yumenegi/object67/README.md

# object67
Object 67 is an attempt at an AES-67-2013 compliant network D/AC studios and home audio.
