yumenegi/object67/eddy/notes.txt

Eddy's to do list because he's stupid:
    Spec PHY
        Configure in STM32MX

    Configure MCU in MX
        Active peripherals:
            USB PHY
            SPDIFRX
            SAI x2
                Input & output

Notes for display:
    Baud rate 38,400bps
        Configure with J1 and J2
    Find voltage
    Leave J2 open for Asynchronous
