yumenegi/object67/kicad_libs/LIB_TORX1950A_F_/TORX1950A_F_/3D/TORX1950A_F_.stp

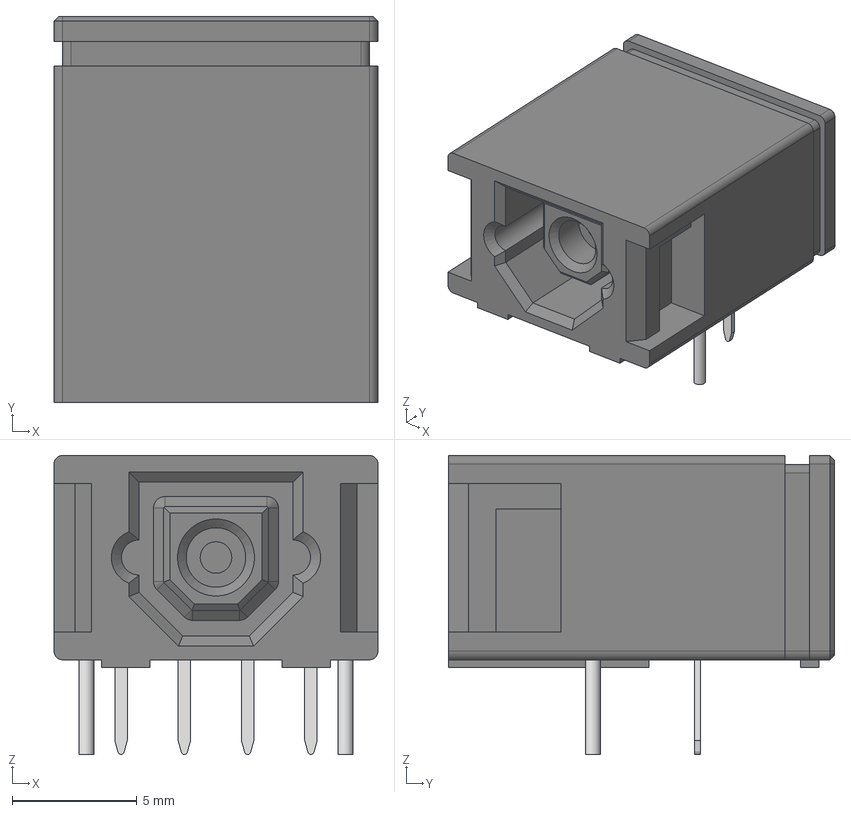
[picture p1: CAD file, 2026-02-16]
kicad_libs/LIB_TORX1950A_F_/TORX1950A_F_/3D/TORX1950A_F_.stp
13.0 x 15.5 x 12.0 mm
