yumenegi/object67/models/ADP5070AREZ/3D/ADP5070AREZ.stp

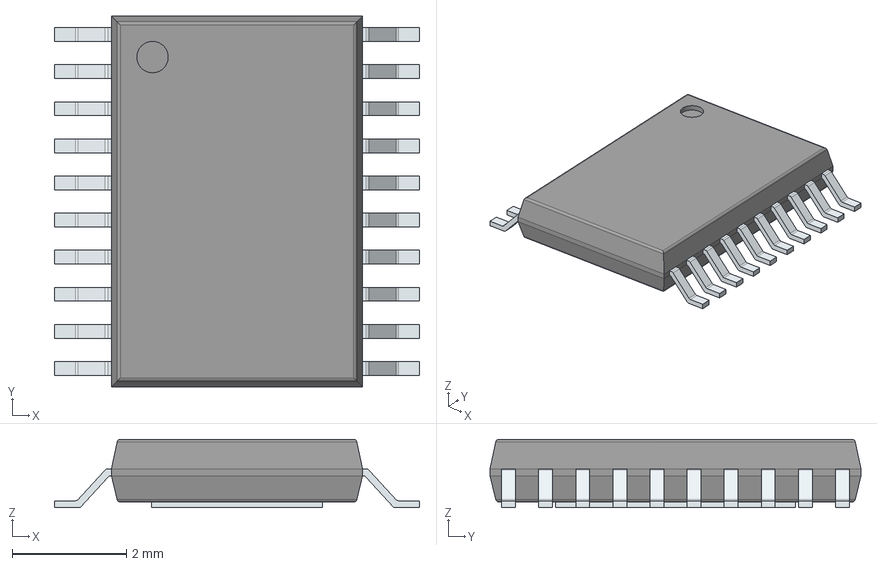
[picture p2: CAD file, 2026-03-09]
models/ADP5070AREZ/3D/ADP5070AREZ.stp
6.40 x 6.50 x 1.20 mm
PinsArrayLR
ThermalPad
