yumenegi/object67/models/AK4493SEQ/3D/AK4493SEQ.stp

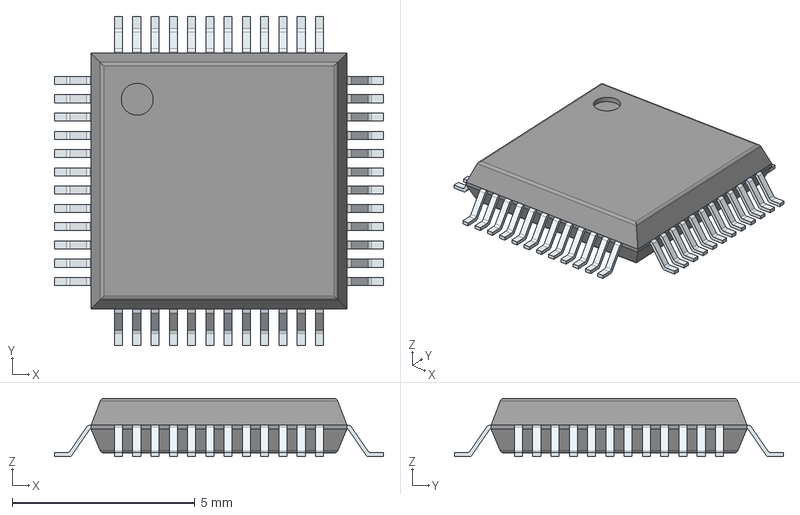
[picture p3: CAD file, 2026-02-12]
models/AK4493SEQ/3D/AK4493SEQ.stp
9.00 x 9.00 x 1.60 mm
PinsArrayLR
PinsArrayTB
