yumenegi/object67/models/AK5572EN/3D/AK5572EN.stp

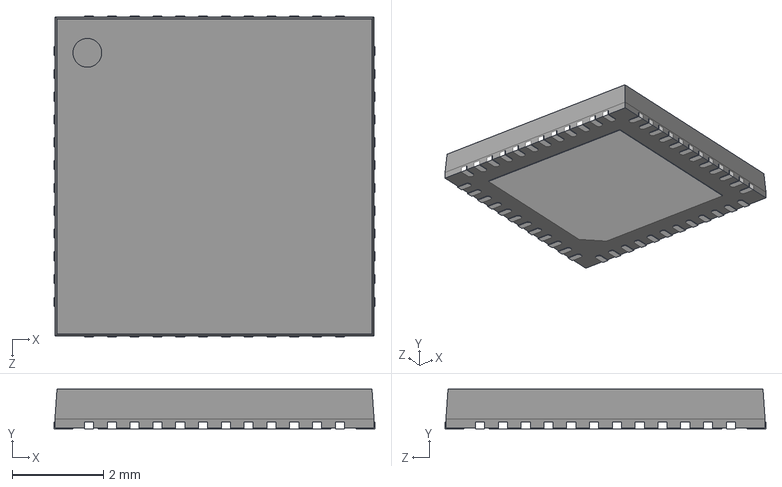
[picture p4: CAD file, 2026-02-12]
models/AK5572EN/3D/AK5572EN.stp
7.04 x 0.87 x 7.04 mm
