yumenegi/object67/models/ASDLJ-E-45.1584MHz-L-R-T/3D/ASDLJ-E-45.1584MHz-L-R-T.stp

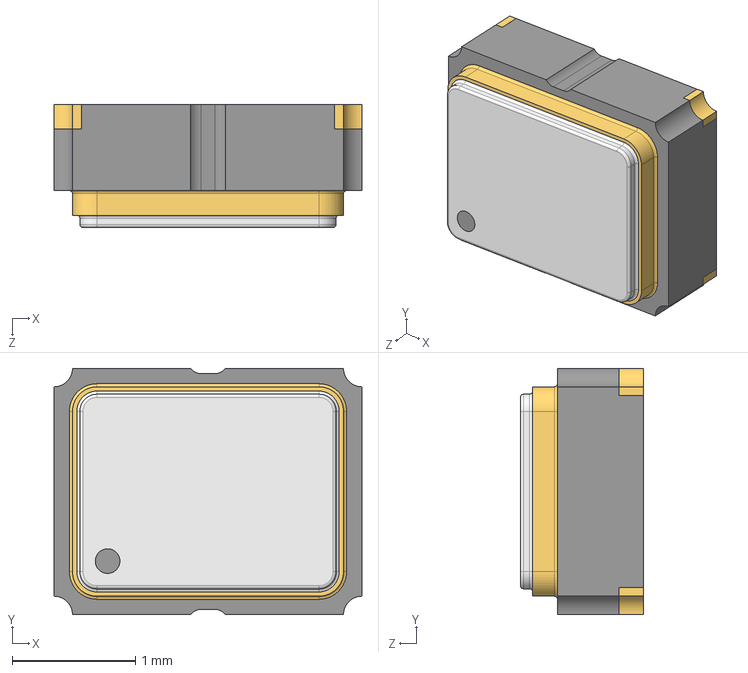
[picture p5: CAD file, 2026-03-07]
models/ASDLJ-E-45.1584MHz-L-R-T/3D/ASDLJ-E-45.1584MHz-L-R-T.stp
2.50 x 2.00 x 1.00 mm
