yumenegi/object67/models/ASDLJ-E-49.152MHZ-L-R-T/3D/ASDLJ-E-49.152MHZ-L-R-T.stp

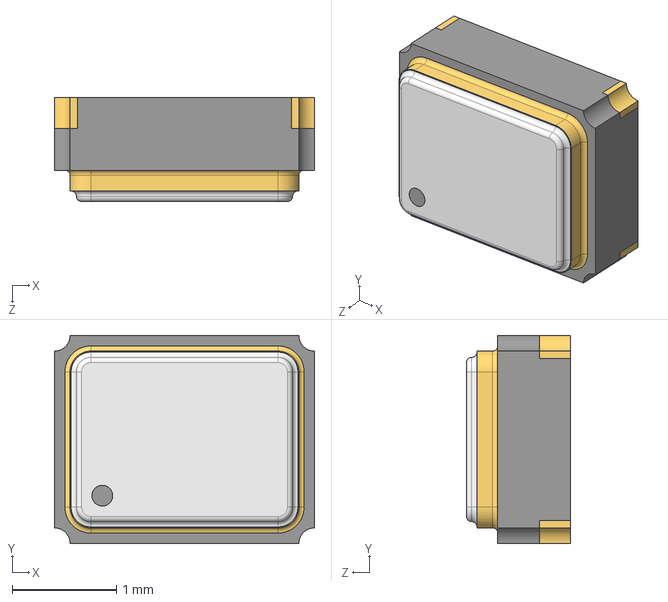
[picture p6: CAD file, 2026-03-07]
models/ASDLJ-E-49.152MHZ-L-R-T/3D/ASDLJ-E-49.152MHZ-L-R-T.stp
2.50 x 2.00 x 1.00 mm
