yumenegi/object67/models/DQN0004A/DQN0004A.stp

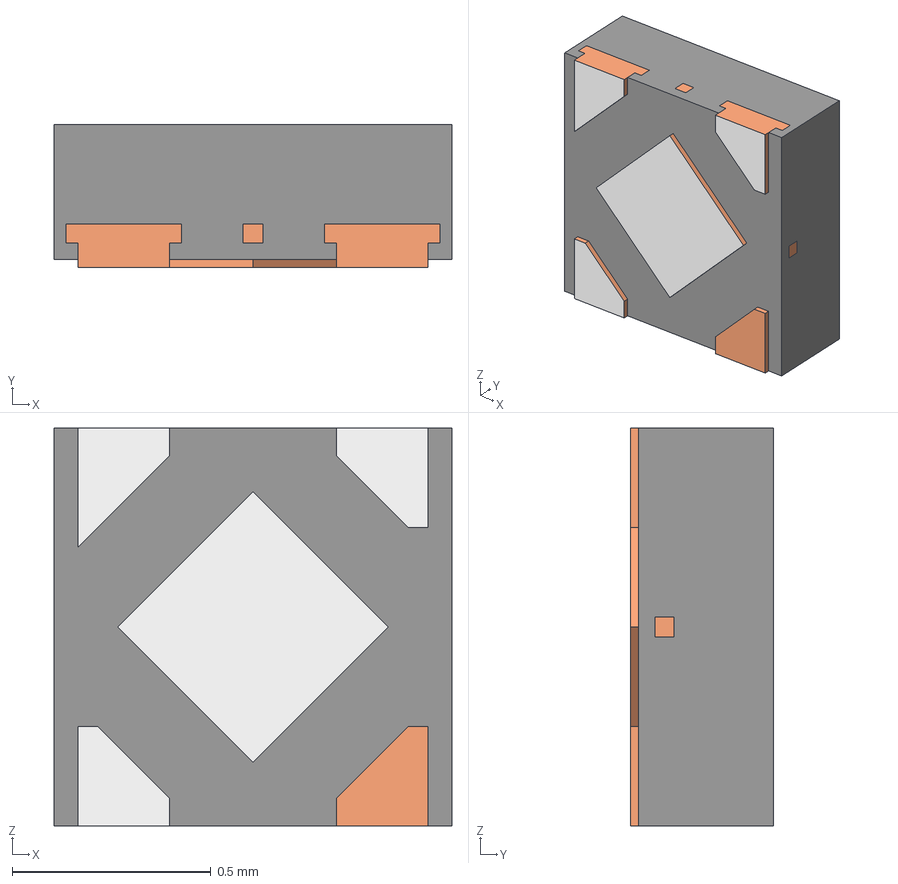
[picture p7: CAD file, 2026-03-09]
models/DQN0004A/DQN0004A.stp
1.00 x 0.36 x 1.00 mm
MOLD-SNB04A
FRAME-SNB04A
