yumenegi/object67/models/LMK1C1104DQFR/3D/LMK1C1104DQFR.stp

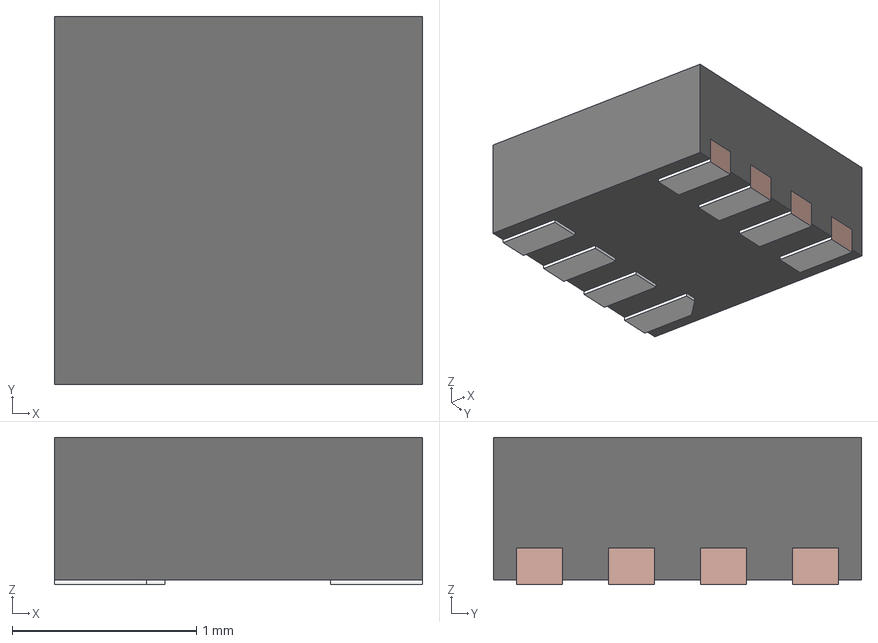
[picture p8: CAD file, 2026-02-12]
models/LMK1C1104DQFR/3D/LMK1C1104DQFR.stp
2.00 x 2.00 x 0.8 mm
FRAME
MOLD
