yumenegi/object67/models/LMK1C1104PWR/3D/LMK1C1104PWR.stp

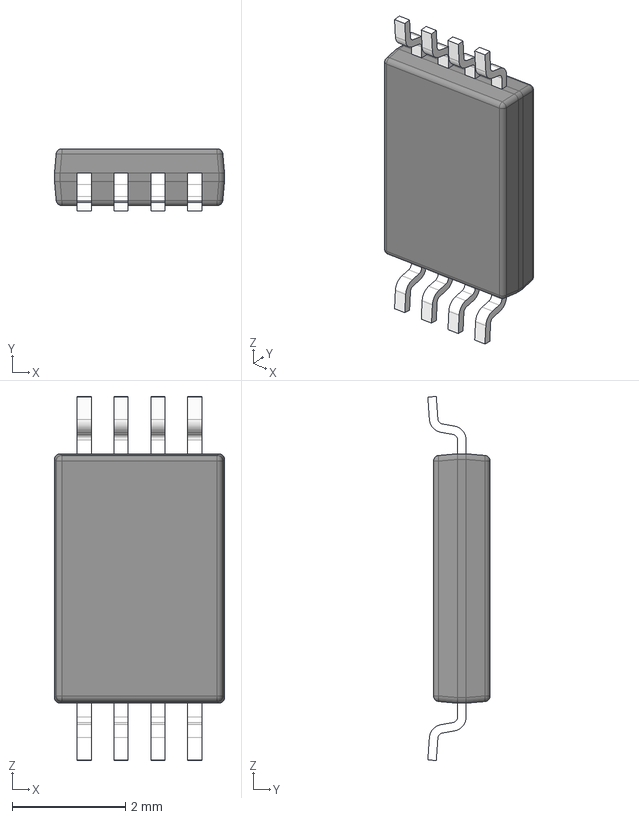
[picture p9: CAD file, 2026-02-12]
models/LMK1C1104PWR/3D/LMK1C1104PWR.stp
3.00 x 1.10 x 6.42 mm
BODY-SO
LEAD-SO x 8
PIN1-ID
