yumenegi/object67/models/OPA1612AIDRGR/3D/OPA1612AIDRGR.stp

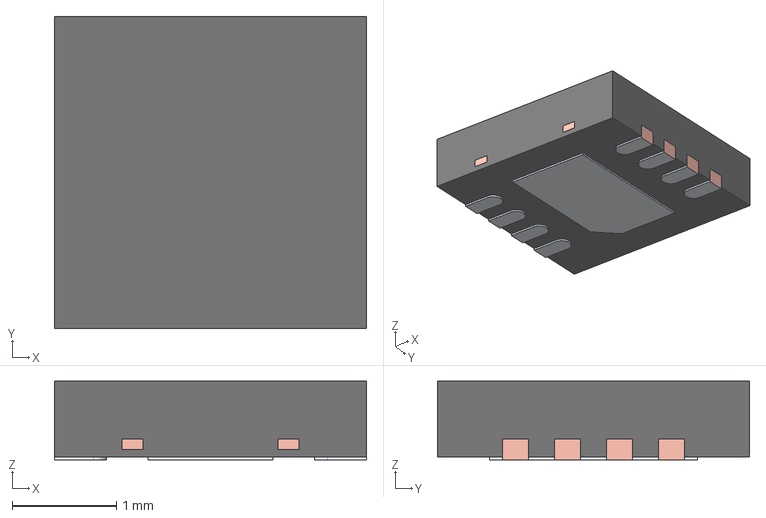
[picture p10: CAD file, 2026-03-09]
models/OPA1612AIDRGR/3D/OPA1612AIDRGR.stp
3.00 x 3.00 x 0.755 mm
BODY-SON
FRAME-DRG0008A
