yumenegi/object67/models/PJ-037A/3D/PJ-037A.stp

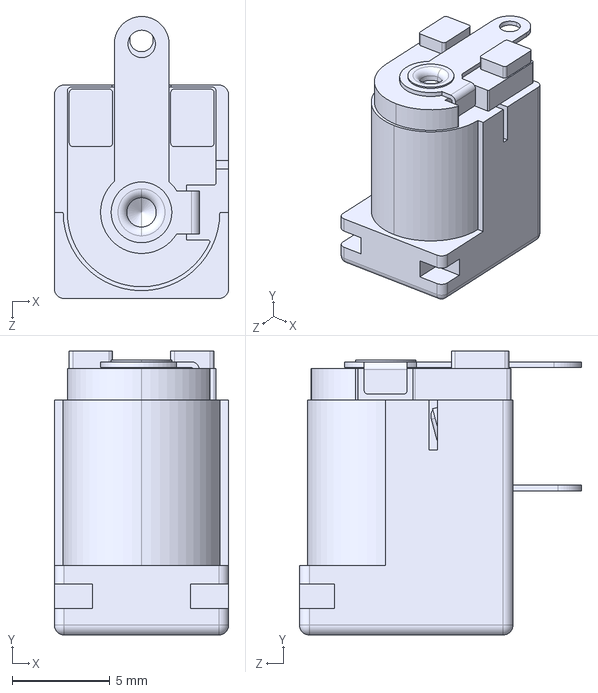
[picture p11: CAD file, 2026-03-07]
models/PJ-037A/3D/PJ-037A.stp
8.90 x 14.5 x 14.4 mm
