yumenegi/object67/models/RCJ2223/RCJ-2223.step

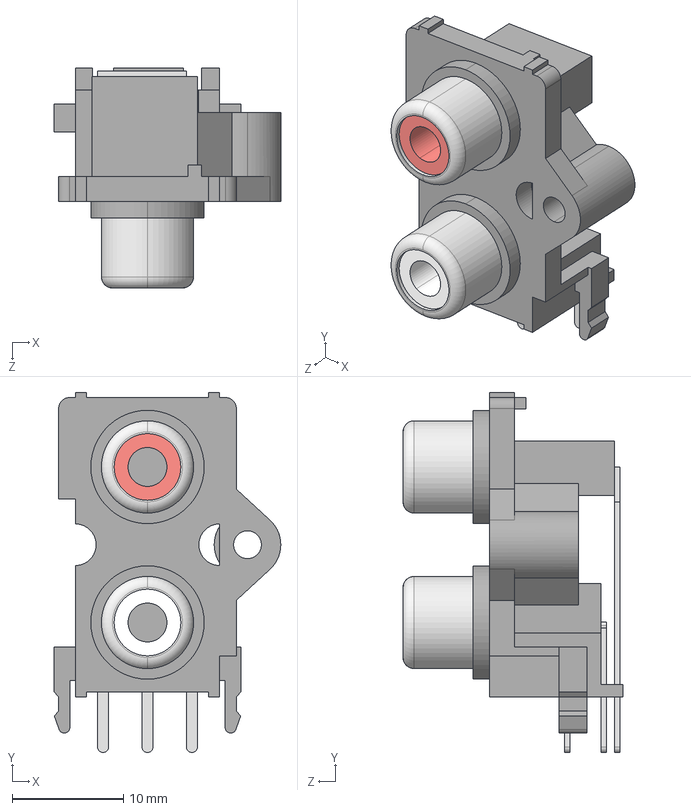
[picture p12: CAD file, 2026-02-24]
models/RCJ2223/RCJ-2223.step
20.4 x 32.4 x 19.8 mm
RCJ-22_RCJ-22XX
PLUG_Red
PLUG_White
