yumenegi/object67/models/TAA5242IRGER/3D/TAA5242IRGER.stp

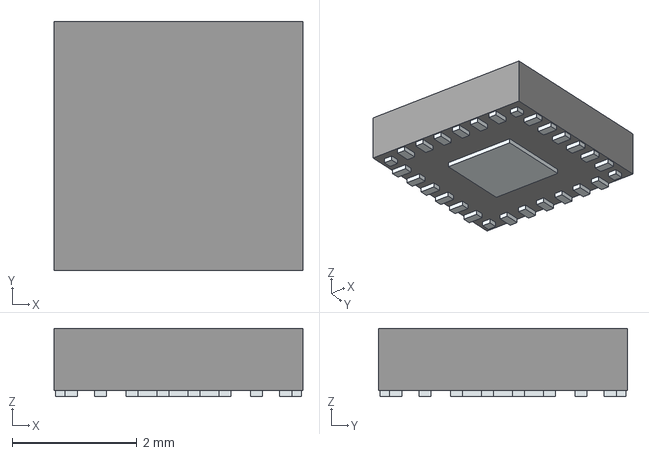
[picture p13: CAD file, 2026-02-12]
models/TAA5242IRGER/3D/TAA5242IRGER.stp
4.00 x 4.00 x 1.10 mm
Pins
