yumenegi/object67/models/TPA6120A2DWPR/3D/TPA6120A2DWPR.stp

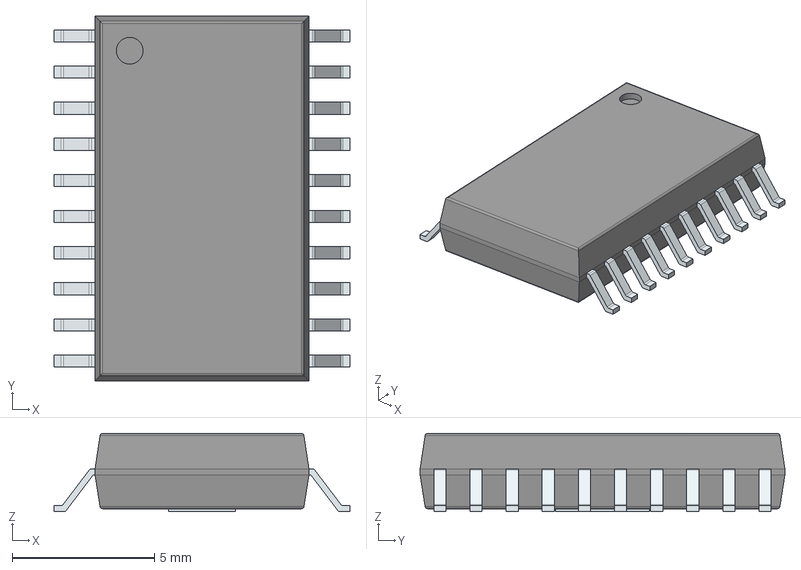
[picture p14: CAD file, 2026-02-24]
models/TPA6120A2DWPR/3D/TPA6120A2DWPR.stp
10.4 x 12.8 x 2.75 mm
PinsArrayLR
ThermalPad
