yumenegi/object67/models/TPS62912/RPU0010A.stp

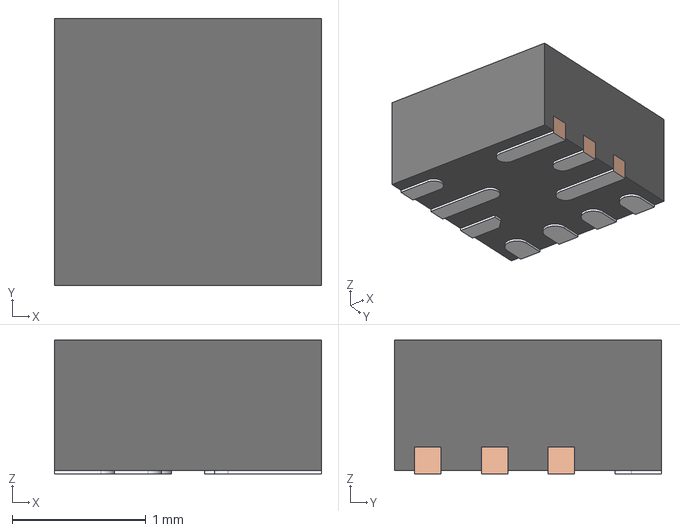
[picture p15: CAD file, 2026-03-09]
models/TPS62912/RPU0010A.stp
2.00 x 2.00 x 1.00 mm
FRAME
MOLD
