yumenegi/object67/models/TPS7A3301RGWR/3D/TPS7A3301RGWR.stp

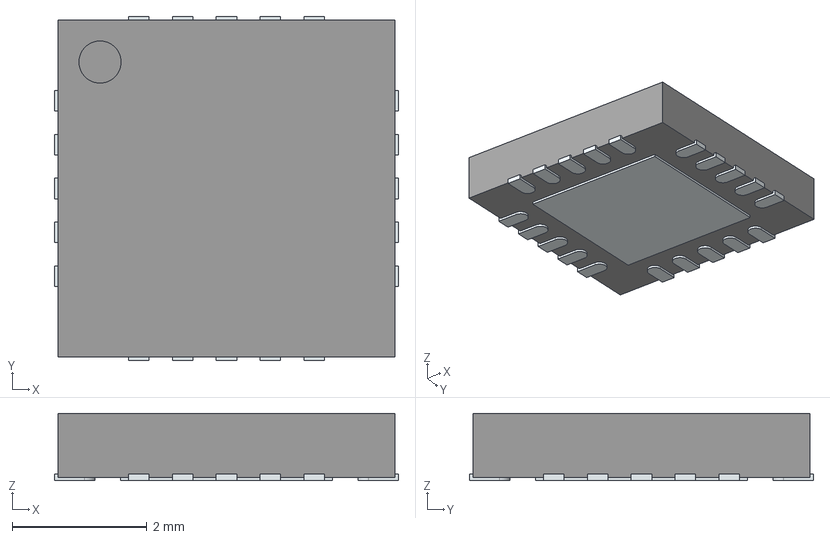
[picture p16: CAD file, 2026-03-07]
models/TPS7A3301RGWR/3D/TPS7A3301RGWR.stp
5.10 x 5.10 x 1.00 mm
ThermalPin
PinsArrayLR
PinsArrayTB
