yumenegi/object67/models/216700-0249/3D/216700-0249.stp

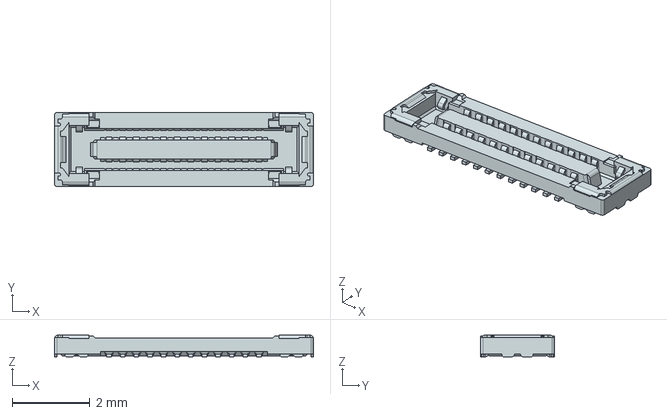
[picture p17: CAD file, 2026-03-07]
models/216700-0249/3D/216700-0249.stp
6.65 x 1.90 x 0.56 mm
