yumenegi/object67/(list of files, cad)

Other CAD files:
models/TPS7A4701RGWT/3D/TPS7A4701RGWT.stp
kicad_libs/LIB_TORX1950A_F_/TORX1950A_F_/Allegro/torx1950af.psm
kicad_libs/LIB_TORX1950A_F_/TORX1950A_F_/DEHDL/torx1950a_f_/chips/chips.prt
models/216700-0249/Allegro/2167000249.psm
models/216700-0249/DEHDL/216700_0249/chips/chips.prt
models/505270-2412/3D/505270-2412.stp
models/505270-2412/Allegro/5052702412.psm
models/505270-2412/DEHDL/505270_2412/chips/chips.prt
models/ADP5070AREZ/Allegro/sop65p640x120-21n.psm
models/ADP5070AREZ/DEHDL/adp5070arez/chips/chips.prt
models/AK4493SEQ/Allegro/qfp50p900x900x160-48n.psm
models/AK4493SEQ/DEHDL/ak4493seq/chips/chips.prt
models/AK5572EN/Allegro/qfn50p700x700x100-49n-d.psm
models/AK5572EN/DEHDL/ak5572en/chips/chips.prt
models/ASDLJ-E-45.1584MHz-L-R-T/Allegro/asdlje451584mhzlrt.psm
models/ASDLJ-E-45.1584MHz-L-R-T/DEHDL/asdlj_e_45.1584mhz_l_r_t/chips/chips.prt
models/ASDLJ-E-49.152MHZ-L-R-T/Allegro/asdlje49152mhzlrt.psm
models/ASDLJ-E-49.152MHZ-L-R-T/DEHDL/asdlj_e_49.152mhz_l_r_t/chips/chips.prt
models/LMK1C1104DQFR/Allegro/son50p200x200x80-8n.psm
models/LMK1C1104DQFR/DEHDL/lmk1c1104dqfr/chips/chips.prt
models/LMK1C1104PWR/Allegro/sop65p640x120-8n.psm
models/LMK1C1104PWR/DEHDL/lmk1c1104pwr/chips/chips.prt
models/OPA1612AIDRGR/Allegro/son50p300x300x80-9n-d.psm
models/OPA1612AIDRGR/DEHDL/opa1612aidrgr/chips/chips.prt
models/PJ-037A/Allegro/pj037a.psm
models/PJ-037A/DEHDL/pj_037a/chips/chips.prt
models/TAA5242IRGER/Allegro/taa5242irger.psm
models/TAA5242IRGER/DEHDL/taa5242irger/chips/chips.prt
models/TPA6120A2DWPR/Allegro/soic127p1040x275-21n.psm
models/TPA6120A2DWPR/DEHDL/tpa6120a2dwpr/chips/chips.prt
models/TPS7A3301RGWR/Allegro/qfn65p500x500x100-21n-d.psm
models/TPS7A3301RGWR/DEHDL/tps7a3301rgwr/chips/chips.prt
models/TPS7A4701RGWT/Allegro/qfn65p500x500x100-21n-d.psm
models/TPS7A4701RGWT/DEHDL/tps7a4701rgwt/chips/chips.prt
