yumenegi/object67/(list of files, drawings)

Other design files:
models/216700-0249/Altium/216700-0249.SchLib
models/216700-0249/Altium/2167000249.PcbLib
models/505270-2412/Altium/505270-2412.SchLib
models/505270-2412/Altium/5052702412.PcbLib
models/ADP5070AREZ/Altium/ADP5070AREZ.SchLib
models/ADP5070AREZ/Altium/SOP65P640X120-21N.PcbLib
models/AK4493SEQ/Altium/AK4493SEQ.SchLib
models/AK4493SEQ/Altium/QFP50P900X900X160-48N.PcbLib
models/AK5572EN/Altium/AK5572EN.SchLib
models/AK5572EN/Altium/QFN50P700X700X100-49N-D.PcbLib
models/ASDLJ-E-45.1584MHz-L-R-T/Altium/ASDLJ-E-45.1584MHz-L-R-T.SchLib
models/ASDLJ-E-45.1584MHz-L-R-T/Altium/ASDLJE451584MHzLRT.PcbLib
models/ASDLJ-E-49.152MHZ-L-R-T/Altium/ASDLJ-E-49.152MHZ-L-R-T.SchLib
models/ASDLJ-E-49.152MHZ-L-R-T/Altium/ASDLJE49152MHZLRT.PcbLib
models/LMK1C1104DQFR/Altium/LMK1C1104DQFR.SchLib
models/LMK1C1104DQFR/Altium/SON50P200X200X80-8N.PcbLib
models/LMK1C1104PWR/Altium/LMK1C1104PWR.SchLib
models/LMK1C1104PWR/Altium/SOP65P640X120-8N.PcbLib
models/OPA1612AIDRGR/Altium/OPA1612AIDRGR.SchLib
models/OPA1612AIDRGR/Altium/SON50P300X300X80-9N-D.PcbLib
models/PJ-037A/Altium/PJ037A.PcbLib
models/PJ-037A/Altium/PJ-037A.SchLib
models/TAA5242IRGER/Altium/TAA5242IRGER.PcbLib
models/TAA5242IRGER/Altium/TAA5242IRGER.SchLib
models/TPA6120A2DWPR/Altium/SOIC127P1040X275-21N.PcbLib
models/TPA6120A2DWPR/Altium/TPA6120A2DWPR.SchLib
models/TPS7A3301RGWR/Altium/QFN65P500X500X100-21N-D.PcbLib
models/TPS7A3301RGWR/Altium/TPS7A3301RGWR.SchLib
models/TPS7A4701RGWT/Altium/QFN65P500X500X100-21N-D.PcbLib
models/TPS7A4701RGWT/Altium/TPS7A4701RGWT.SchLib
