yumenegi/object67/motor_board/motor_board.kicad_pcb

## KiCad design motor_board/motor_board.kicad_pcb (2026-03-22)

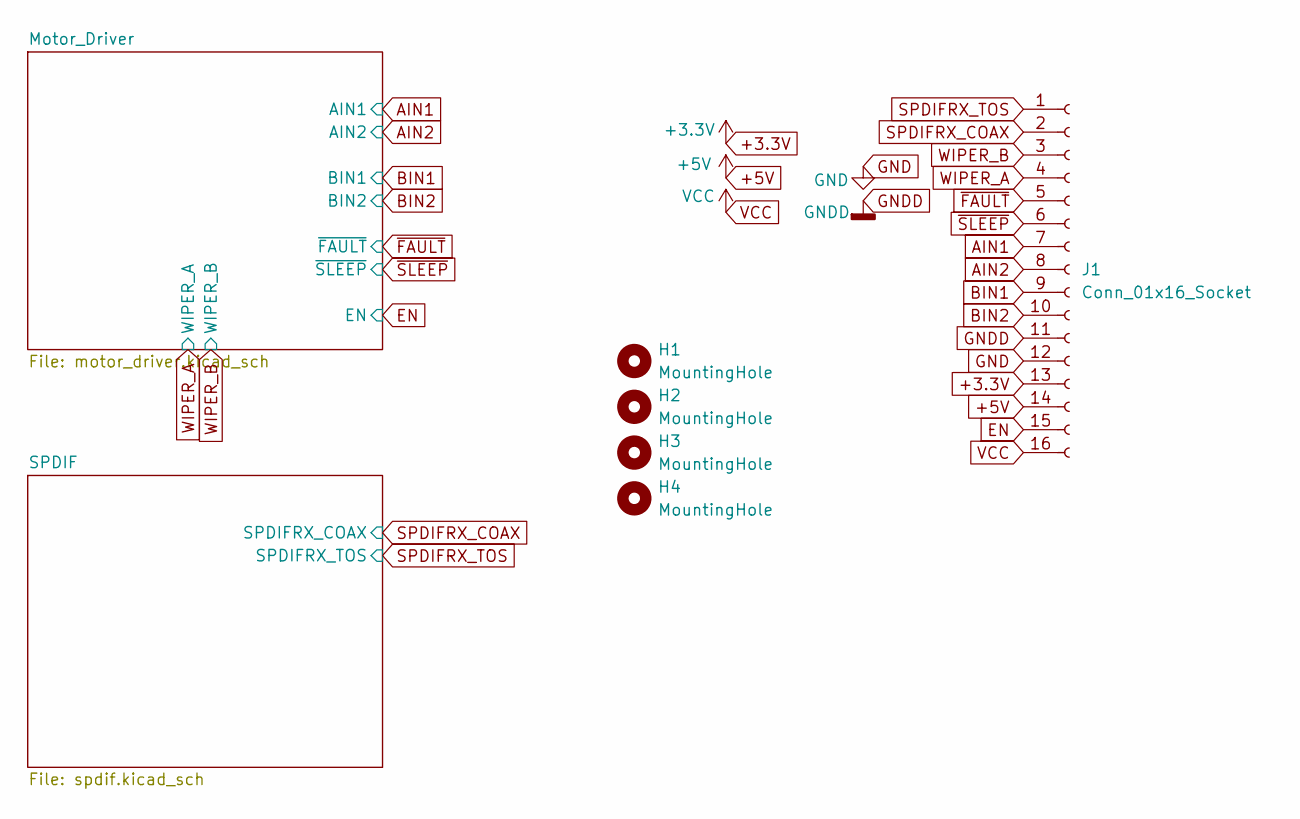
[picture p18: schematic motor_board.kicad_sch]

Parts:
H1, H2, H3, H4: MountingHole; MountingHole_3.2mm_M3
J1: Conn_01x16_Socket; JST_PH_S16B-PH-K_1x16_P2.00mm_Horizontal

Connections:
+3.3V: J1.13; also elsewhere on the board
+5V: J1.14; also elsewhere on the board
AIN1: J1.7; also elsewhere on the board
AIN2: J1.8; also elsewhere on the board
BIN1: J1.9; also elsewhere on the board
BIN2: J1.10; also elsewhere on the board
EN: J1.15; also elsewhere on the board
GND: J1.12; also elsewhere on the board
GNDD: J1.11; also elsewhere on the board
SPDIFRX_COAX: J1.2; also elsewhere on the board
SPDIFRX_TOS: J1.1; also elsewhere on the board
VCC: J1.16; also elsewhere on the board
WIPER_A: J1.4; also elsewhere on the board
WIPER_B: J1.3; also elsewhere on the board
~FAULT: J1.5; also elsewhere on the board
~SLEEP: J1.6; also elsewhere on the board

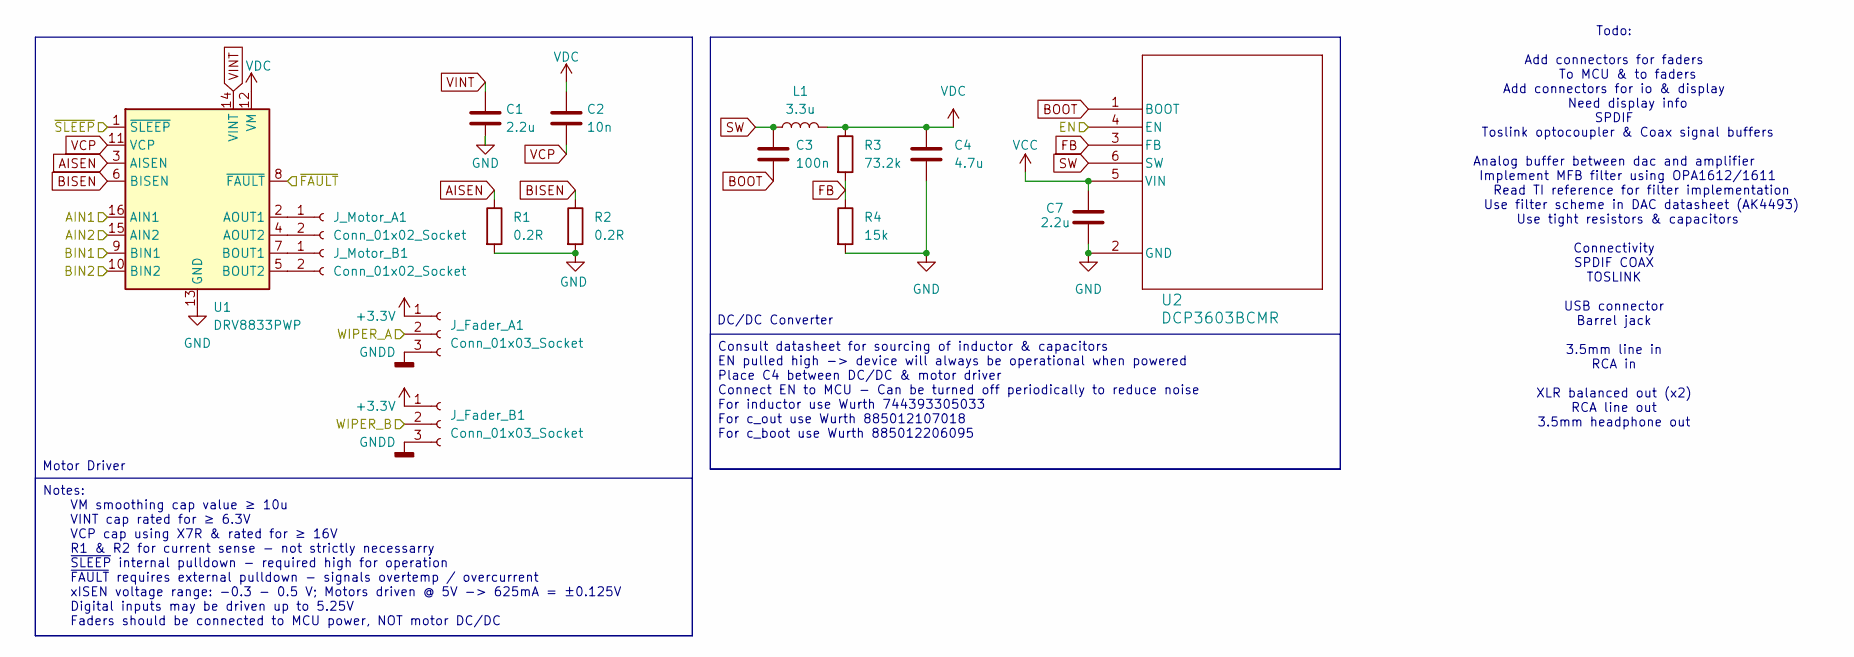
[picture p19: schematic motor_driver.kicad_sch]

Parts:
C1, C7: 2.2u; C_0805_2012Metric_Pad1.18x1.45mm_HandSolder
C2: 10n; C_0805_2012Metric_Pad1.18x1.45mm_HandSolder
C3: 100n; C_0603_1608Metric_Pad1.08x0.95mm_HandSolder
C4: 4.7u; C_0805_2012Metric_Pad1.18x1.45mm_HandSolder
J_Fader_A1: Conn_01x03_Socket; JST_PH_B3B-PH-K_1x03_P2.00mm_Vertical
J_Fader_B1: Conn_01x03_Socket; JST_PH_B3B-PH-K_1x03_P2.00mm_Vertical
J_Motor_A1: Conn_01x02_Socket; JST_PH_B2B-PH-K_1x02_P2.00mm_Vertical
J_Motor_B1: Conn_01x02_Socket; JST_PH_B2B-PH-K_1x02_P2.00mm_Vertical
L1: 3.3u; 744393665033
R1, R2: 0.2R; R_2512_6332Metric_Pad1.40x3.35mm_HandSolder
R3: 73.2k; R_0402_1005Metric_Pad0.72x0.64mm_HandSolder
R4: 15k; R_0402_1005Metric_Pad0.72x0.64mm_HandSolder
U1: DRV8833PWP; HTSSOP-16-1EP_4.4x5mm_P0.65mm_EP3.4x5mm_Mask2.46x2.31mm_The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
U2: DCP3603BCMR; SOT23-6L_1p7x3p01_STM

Connections:
+3.3V: J_Fader_A1.1, J_Fader_B1.1; also elsewhere on the board
AIN1: U1.16 (AIN1); also elsewhere on the board
AIN2: U1.15 (AIN2); also elsewhere on the board
AISEN: R1.1, U1.3 (AISEN)
BIN1: U1.9 (BIN1); also elsewhere on the board
BIN2: U1.10 (BIN2); also elsewhere on the board
BISEN: R2.1, U1.6 (BISEN)
BOOT: C3.2, U2.1 (BOOT)
EN: U2.4 (EN); also elsewhere on the board
FB: R3.2, R4.1, U2.3 (FB)
GND: C1.2, C4.2, C7.2, R1.2, R2.2, R4.2, U1.13 (GND), U1.17 (GND), U2.2 (GND); also elsewhere on the board
GNDD: J_Fader_A1.3, J_Fader_B1.3; also elsewhere on the board
unnamed: J_Motor_A1.1, U1.2 (AOUT1)
unnamed: J_Motor_A1.2, U1.4 (AOUT2)
unnamed: J_Motor_B1.1, U1.7 (BOUT1)
unnamed: J_Motor_B1.2, U1.5 (BOUT2)
SW: C3.1, L1.1, U2.6 (SW)
VCC: C7.1, U2.5 (VIN); also elsewhere on the board
VCP: C2.2, U1.11 (VCP)
VDC: C2.1, C4.1, L1.2, R3.1, U1.12 (VM)
VINT: C1.1, U1.14 (VINT)
WIPER_A: J_Fader_A1.2; also elsewhere on the board
WIPER_B: J_Fader_B1.2; also elsewhere on the board
~FAULT: U1.8 (~FAULT); also elsewhere on the board
~SLEEP: U1.1 (~SLEEP); also elsewhere on the board

Notes on the sheet:
DC/DC Converter
Motor Driver
Todo: Add connectors for faders To MCU & to faders Add connectors for io & display Need display info SPDIF Toslink optocoupler & Coax signal buffers Analog buffer between dac and amplifier Implement MFB filter using OPA1612/1611 Read TI reference for filter implementation Use filter scheme in DAC d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
Notes: VM smoothing cap value ≥ 10u VINT cap rated for ≥ 6.3V VCP cap using X7R & rated for ≥ 16V R1 & R2 for current sense - not strictly necessarry ~{SLEEP} internal pulldown - required high for operation ~{FAULT} requires external pulldown - signals overtemp / overcurrent xISEN voltage range: -0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
Consult datasheet for sourcing of inductor & capacitors EN pulled high -> device will always be operational when powered Place C4 between DC/DC & motor driver Connect EN to MCU - Can be turned off periodically to reduce noise For inductor use Wurth 744393305033 For c_out use Wurth 885012107018 For 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

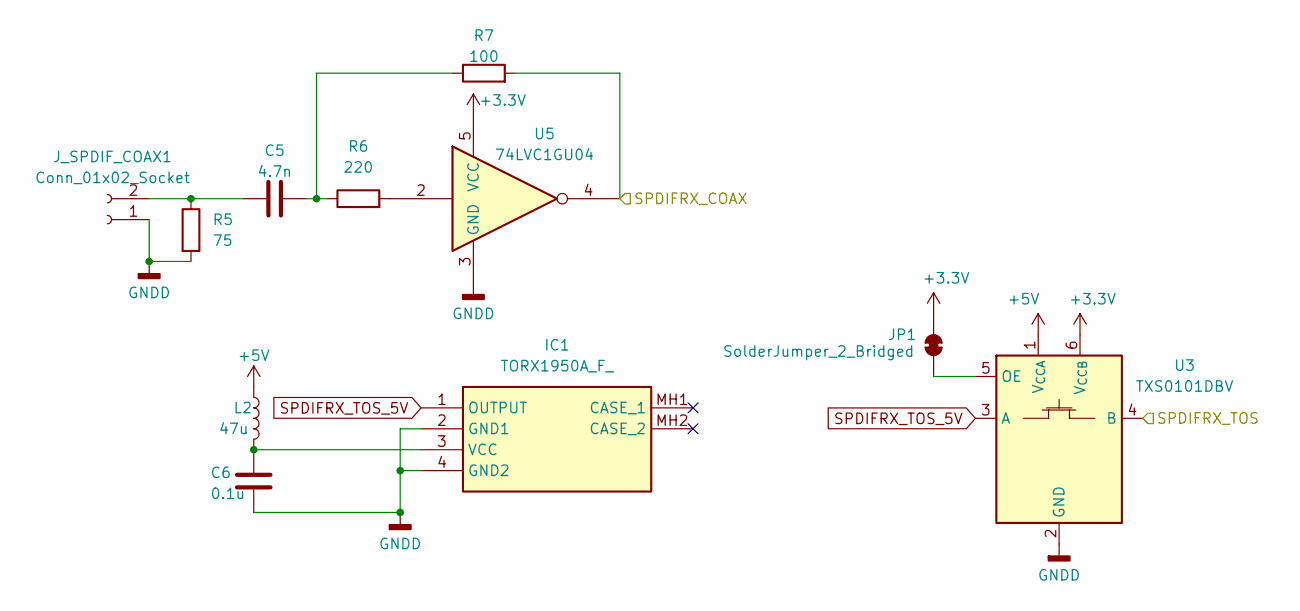
[picture p20: schematic spdif.kicad_sch]

Parts:
C5: 4.7n; C_0805_2012Metric_Pad1.18x1.45mm_HandSolder
C6: 0.1u; C_0603_1608Metric_Pad1.08x0.95mm_HandSolder
IC1: TORX1950A_F_; TORX1950AF; Manufacturer_Part_Number TORX1950A(F); Mouser Part Number 71-TORX1950A(F)
JP1: SolderJumper_2_Bridged; SolderJumper-2_P1.3mm_Bridged_RoundedPad1.0x1.5mm
J_SPDIF_COAX1: Conn_01x02_Socket; JST_PH_B2B-PH-K_1x02_P2.00mm_Vertical
L2: 47u; L_Vishay_IHLP-4040
R5: 75; R_0805_2012Metric_Pad1.20x1.40mm_HandSolder
R6: 220; R_0805_2012Metric_Pad1.20x1.40mm_HandSolder
R7: 100; R_0805_2012Metric_Pad1.20x1.40mm_HandSolder
U3: TXS0101DBV; SOT-23-6
U5: 74LVC1GU04; SOT-23-5

Connections:
+3.3V: JP1.2 (B), U3.6 (V_{CCB}), U5.5 (VCC); also elsewhere on the board
+5V: L2.1, U3.1 (V_{CCA}); also elsewhere on the board
GNDD: C6.2, IC1.2 (GND1), IC1.4 (GND2), J_SPDIF_COAX1.1, R5.2, U3.2 (GND), U5.3 (GND); also elsewhere on the board
unnamed: C5.2, R6.1, R7.1
unnamed: C6.1, IC1.3 (VCC), L2.2
unnamed: JP1.1 (A), U3.5 (OE)
unnamed: C5.1, J_SPDIF_COAX1.2, R5.1
unnamed: R6.2, U5.2
SPDIFRX_COAX: R7.2, U5.4; also elsewhere on the board
SPDIFRX_TOS: U3.4 (B); also elsewhere on the board
SPDIFRX_TOS_5V: IC1.1 (OUTPUT), U3.3 (A)

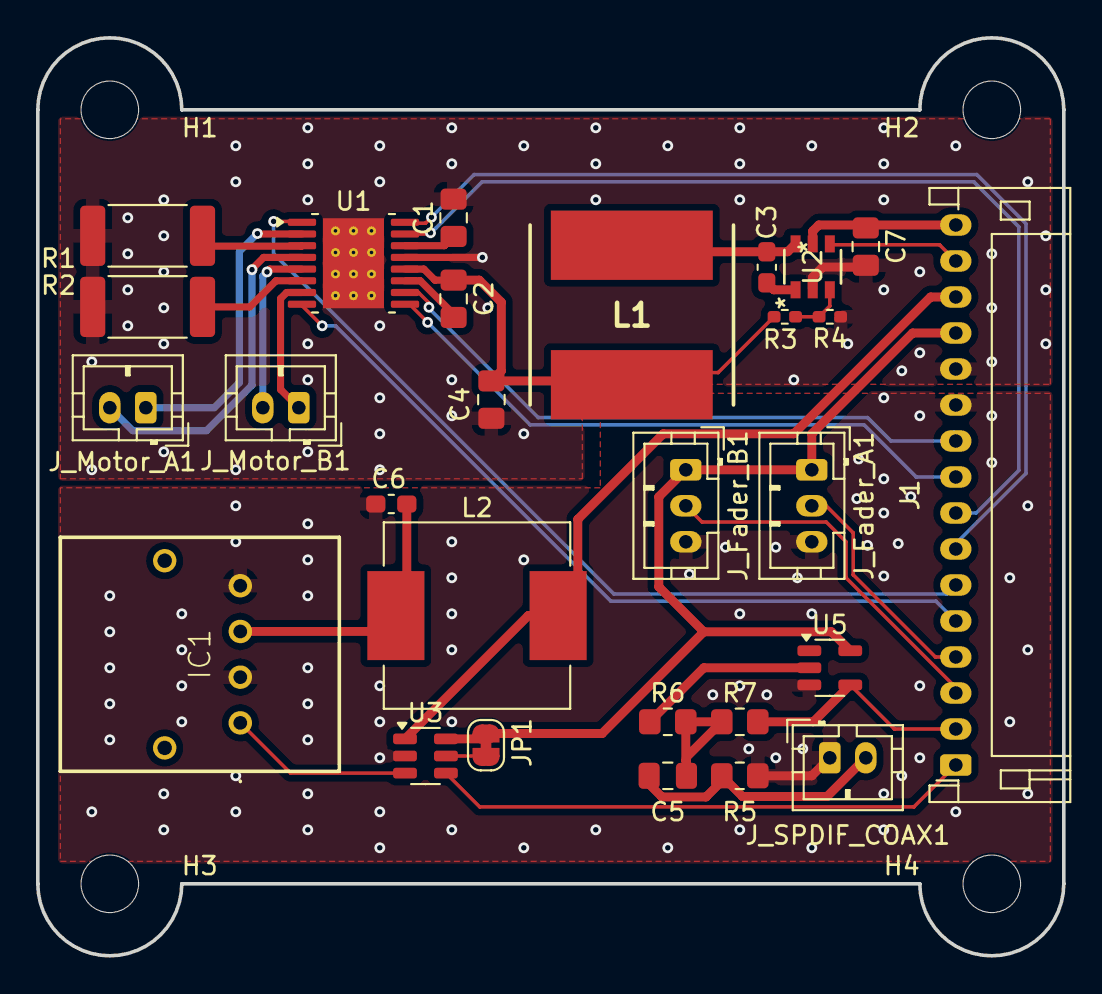
[picture p21: board motor_board.kicad_pcb from above]

Board: 2 copper layers, 57.0 x 51.0 mm, 32 parts (0 on the bottom side), 34 nets.
