yumenegi/object67/object67/object67.kicad_pcb

## KiCad design object67/object67.kicad_pcb (2026-03-12)

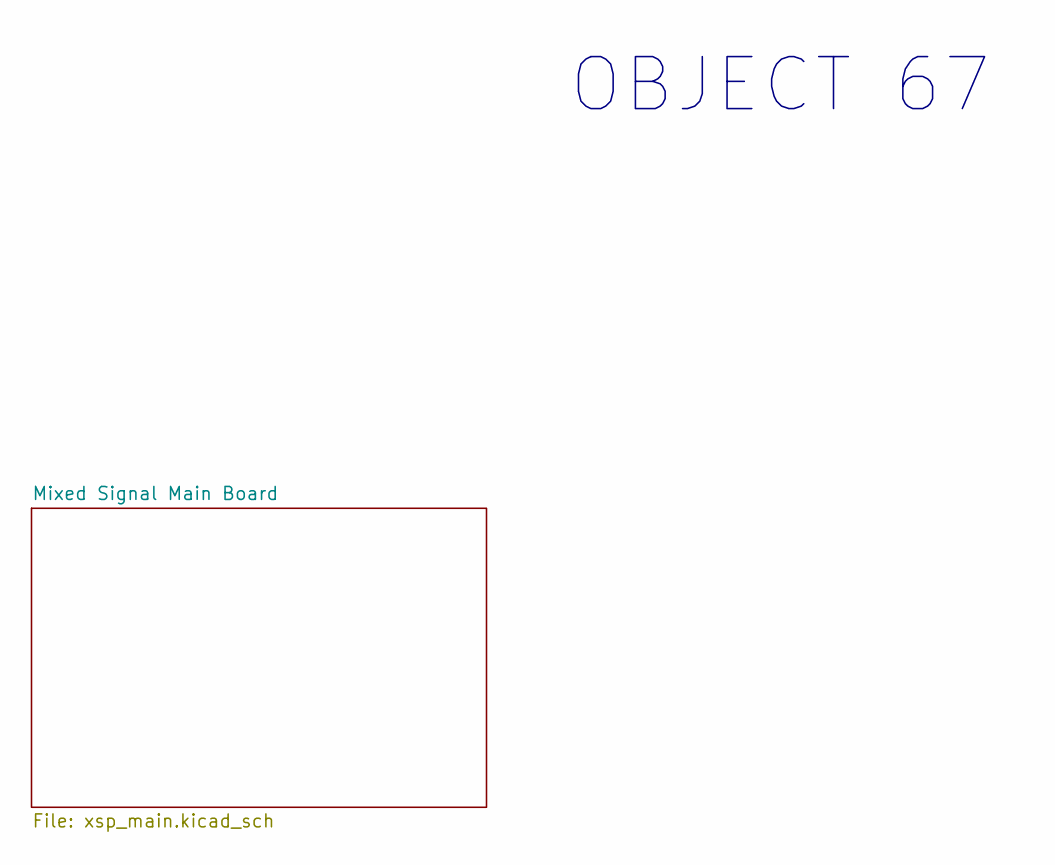
[picture p22: schematic object67.kicad_sch]

Notes on the sheet:
OBJECT 67

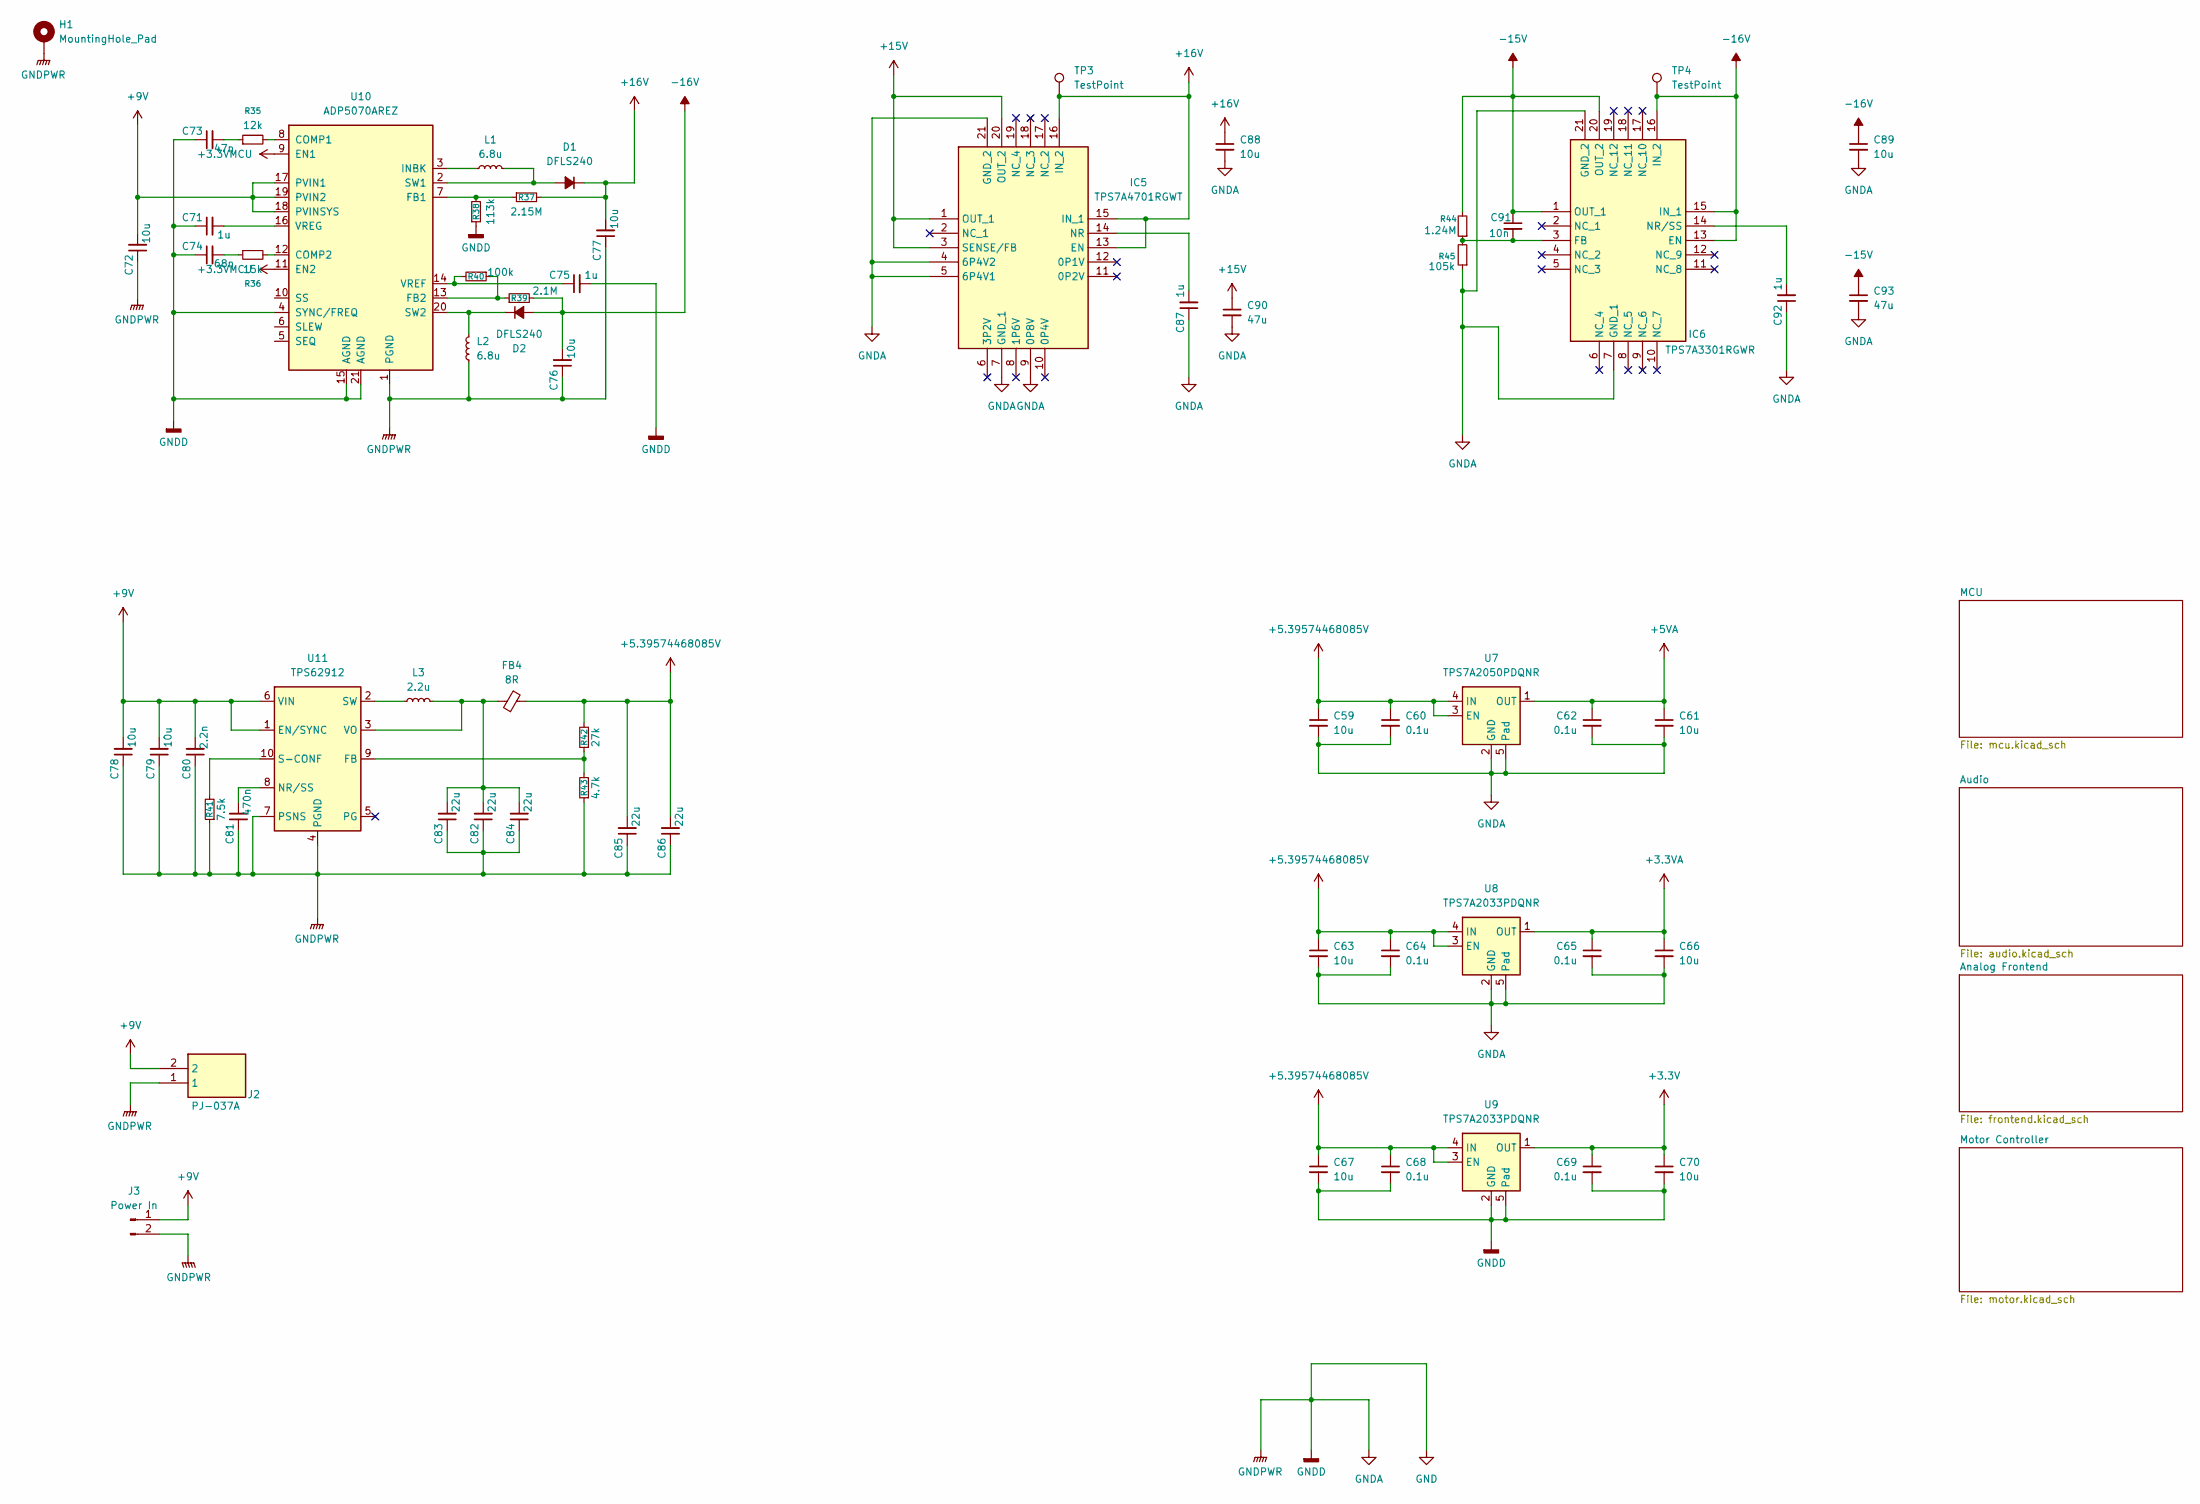
[picture p23: schematic xsp_main.kicad_sch, Power and Distribution Board]

Parts:
C59, C61, C63, C66, C67, C70: 10u; C_0603_1608Metric
C60, C62, C64, C65, C68, C69: 0.1u; C_0603_1608Metric
C71, C75: 1u; C_0603_1608Metric
C72, C78, C79: 10u; C_0805_2012Metric
C73: 47n; C_0603_1608Metric
C74: 68n; C_0603_1608Metric
C76, C77, C88, C89: 10u; C_1206_3216Metric
C80: 2.2n; C_0402_1005Metric
C81: 470n; C_0805_2012Metric
C82, C83, C84, C85, C86: 22u; C_0805_2012Metric
C87: 1u; C_0805_2012Metric
C90, C93: 47u; C_1206_3216Metric
C91: 10n; C_0402_1005Metric
C92: 1u; C_1206_3216Metric
D1, D2: DFLS240; D_PowerDI-123
FB4: 8R; L_0603_1608Metric
H1: MountingHole_Pad; MountingHole_4.3mm_M4_ISO7380_Pad_TopOnly
IC5: TPS7A4701RGWT; QFN65P500X500X100-21N-D; Manufacturer_Part_Number TPS7A4701RGWT; Mouser Part Number 595-TPS7A4701RGWT
IC6: TPS7A3301RGWR; QFN65P500X500X100-21N-D; Manufacturer_Part_Number TPS7A3301RGWR; Mouser Part Number 595-TPS7A3301RGWR
J2: PJ-037A; PJ037A; Manufacturer_Part_Number PJ-037A; Mouser Part Number 490-PJ-037A
J3: Power In; TestPoint_2Pads_Pitch5.08mm_Drill1.3mm
L1, L2: 6.8u; L_Wuerth_MAPI-4030
L3: 2.2u; L_Wuerth_MAPI-4030
R35: 12k; R_0603_1608Metric
R36: 15k; R_0603_1608Metric
R37: 2.15M; R_0603_1608Metric
R38: 113k; R_0603_1608Metric
R39: 2.1M; R_0603_1608Metric
R40: 100k; R_0603_1608Metric
R41: 7.5k; R_0603_1608Metric
R42: 27k; R_0603_1608Metric
R43: 4.7k; R_0603_1608Metric
R44: 1.24M; R_0805_2012Metric
R45: 105k; R_0805_2012Metric
TP3, TP4: TestPoint; TestPoint_Pad_D1.0mm
U7: TPS7A2050PDQNR; Texas_X2SON-4_1x1mm_P0.65mm
U8, U9: TPS7A2033PDQNR; Texas_X2SON-4_1x1mm_P0.65mm
U10: ADP5070AREZ; SOP65P640X120-21N
U11: TPS62912; Texas_RPU0010A_VQFN-HR-10_2x2mm_P0.5mm

Connections:
+3.3V: C69.1, C70.1, U9.1 (OUT); also elsewhere on the board
+3.3VA: C65.1, C66.1, U8.1 (OUT); also elsewhere on the board
+3.3VMCU: U10.9 (EN1), U10.11 (EN2); also elsewhere on the board
+5.39574468085V: C59.1, C60.1, C63.1, C64.1, C67.1, C68.1, C85.2, C86.2, FB4.2, R42.2, U7.3 (EN), U7.4 (IN), U8.3 (EN), U8.4 (IN), U9.3 (EN), U9.4 (IN); also elsewhere on the board
+5VA: C61.1, C62.1, U7.1 (OUT); also elsewhere on the board
+15V: C90.1, IC5.1 (OUT_1), IC5.3 (SENSE/FB), IC5.20 (OUT_2); also elsewhere on the board
+16V: C77.2, C88.1, D1.1 (K), IC5.13 (EN), IC5.15 (IN_1), IC5.16 (IN_2), R37.2, TP3.1
-15V: C91.1, C93.1, IC6.1 (OUT_1), IC6.20 (OUT_2), R44.2; also elsewhere on the board
-16V: C76.2, C89.1, D2.2 (A), IC6.13 (EN), IC6.15 (IN_1), IC6.16 (IN_2), R39.2, TP4.1
GND: C59.2, C60.2, C61.2, C62.2, C63.2, C64.2, C65.2, C66.2, C67.2, C68.2, C69.2, C70.2, C71.1, C72.1, C73.1, C74.1, C75.2, C76.1, C77.1, C78.1, C79.1, C80.1, C81.1, C82.1, C83.1, C84.1, C85.1, C86.1, C87.1, C88.2, C89.2, C90.2, C92.1, C93.2, H1.1, IC5.4 (6P4V2), IC5.5 (6P4V1), IC5.7 (GND_1), IC5.9 (0P8V), IC5.21 (GND_2), IC6.7 (GND_1), IC6.21 (GND_2), J2.1, J3.2, L2.1, R38.1, R41.1, R43.1, R45.1, U7.2 (GND), U7.5 (Pad), U8.2 (GND), U8.5 (Pad), U9.2 (GND), U9.5 (Pad), U10.1 (PGND), U10.4 (SYNC/FREQ), U10.15 (AGND), U10.21 (AGND), U11.4 (PGND), U11.7 (PSNS); also elsewhere on the board
unnamed: C73.2, R35.1
unnamed: C74.2, R36.1
unnamed: D1.2 (A), L1.2, U10.2 (SW1)
unnamed: D2.1 (K), L2.2, U10.20 (SW2)
unnamed: C87.2, IC5.14 (NR)
unnamed: C91.2, IC6.3 (FB), R44.1, R45.2
unnamed: C92.2, IC6.14 (NR/SS)
unnamed: R35.2, U10.8 (COMP1)
unnamed: R36.2, U10.12 (COMP2)
unnamed: R37.1, R38.2, U10.7 (FB1)
unnamed: R39.1, R40.1, U10.13 (FB2)
unnamed: L1.1, U10.3 (INBK)
unnamed: C75.1, R40.2, U10.14 (VREF)
unnamed: C71.2, U10.16 (VREG)
unnamed: R42.1, R43.2, U11.9 (FB)
unnamed: C81.2, U11.8 (NR/SS)
unnamed: R41.2, U11.10 (S-CONF)
unnamed: L3.1, U11.2 (SW)
unnamed: C82.2, C83.2, C84.2, FB4.1, L3.2, U11.3 (VO)
VIN: C72.2, C78.2, C79.2, C80.2, J2.2, J3.1, U10.17 (PVIN1), U10.18 (PVINSYS), U10.19 (PVIN2), U11.1 (EN/SYNC), U11.6 (VIN); also elsewhere on the board

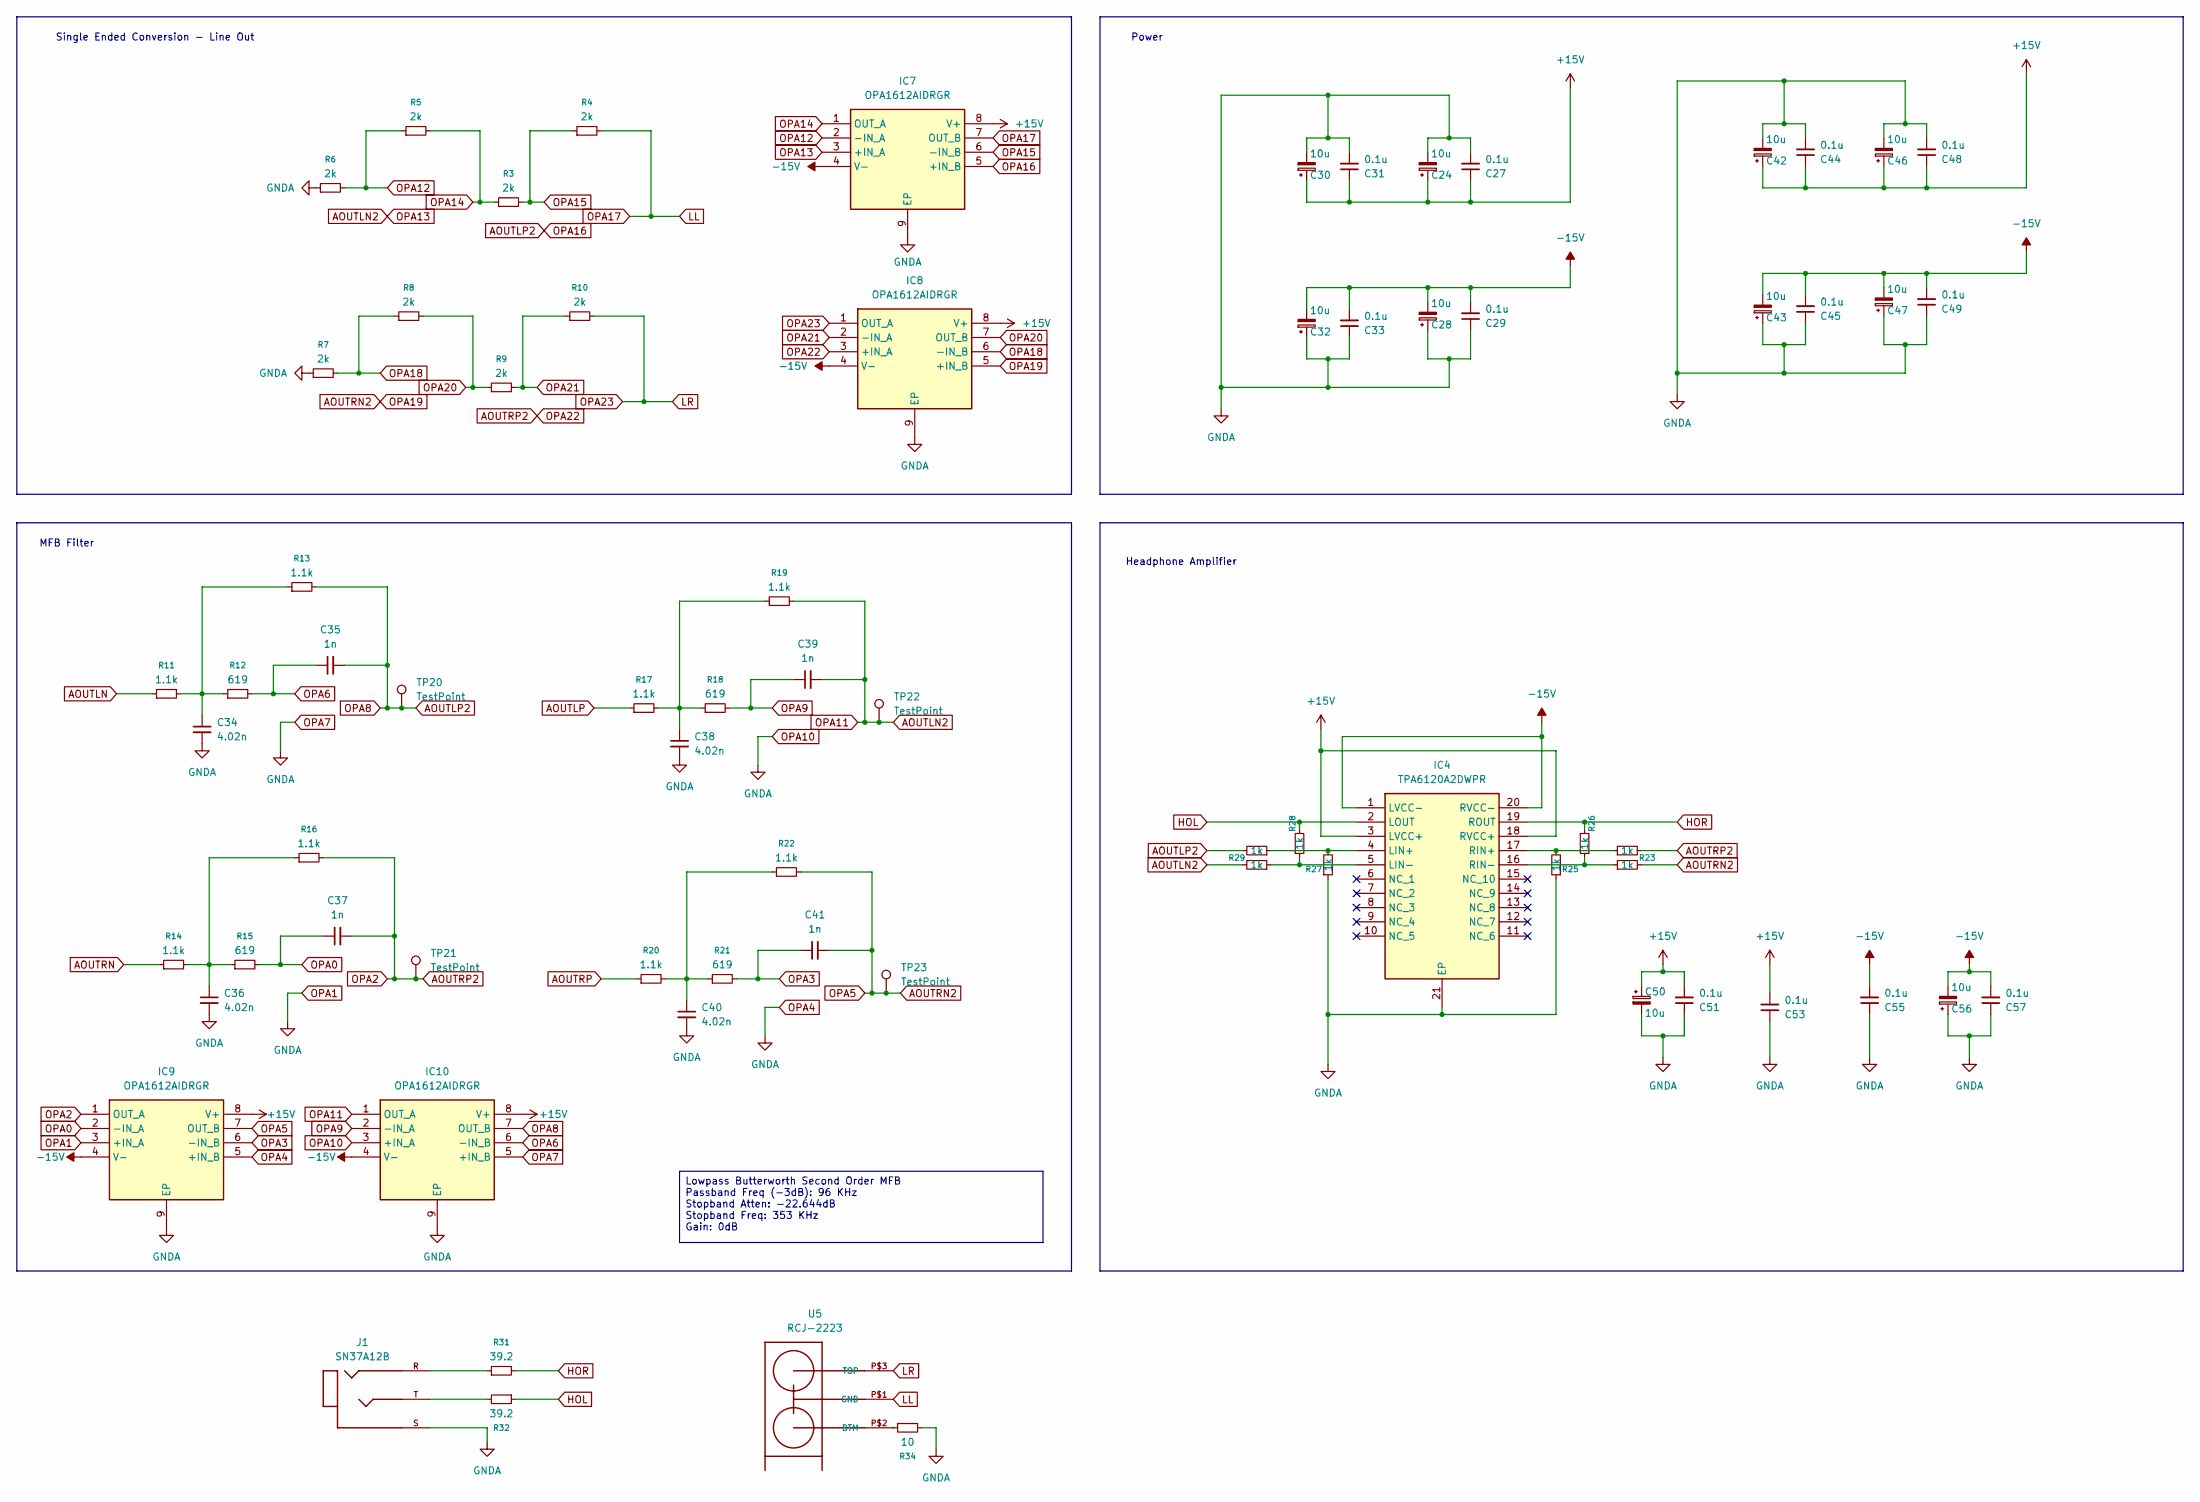
[picture p24: schematic frontend.kicad_sch]

Parts:
C24, C28, C30, C32, C42, C43, C46, C47, C50, C56: 10u; CP_Elec_4x5.3
C27, C29, C31, C33, C44, C45, C48, C49, C51, C53, C55, C57: 0.1u; C_0603_1608Metric
C34, C36, C38, C40: 4.02n; C_0805_2012Metric
C35, C37, C39, C41: 1n; C_0805_2012Metric
IC4: TPA6120A2DWPR; SOIC127P1040X275-21N; Manufacturer_Part_Number TPA6120A2DWPR; Mouser Part Number 595-TPA6120A2DWPR
IC7, IC8, IC9, IC10: OPA1612AIDRGR; WSON-8-1EP_3x3mm_P0.5mm_EP1.2x2mm_ThermalVias; Manufacturer_Part_Number OPA1612AIDRGR; Mouser Part Number 595-OPA1612AIDRGR
J1: SN37A12B; SWITCHCRAFT_SN37A12B; PARTREV F
R3, R4, R5, R6, R7, R8, R9, R10: 2k; R_0603_1608Metric
R11, R13, R14, R16, R17, R19, R20, R22: 1.1k; R_1206_3216Metric
R12, R15, R18, R21: 619; R_1206_3216Metric
R23, R24, R25, R26, R27, R28, R29, R30: 1k; R_0805_2012Metric
R31, R32: 39.2; R_1206_3216Metric
R34: 10; R_1206_3216Metric
TP20, TP21, TP22, TP23: TestPoint; TestPoint_Pad_D1.0mm
U5: RCJ-2223; DUALRCA

Connections:
+15V: C24.1, C27.1, C30.1, C31.1, C42.1, C44.1, C46.1, C48.1, C50.1, C51.2, C53.2, IC4.3 (LVCC+), IC4.18 (RVCC+), IC7.8 (V+), IC8.8 (V+), IC9.8 (V+), IC10.8 (V+); also elsewhere on the board
-15V: C28.2, C29.2, C32.2, C33.2, C43.2, C45.2, C47.2, C49.2, C55.2, C56.2, C57.2, IC4.1 (LVCC-), IC4.20 (RVCC-), IC7.4 (V-), IC8.4 (V-), IC9.4 (V-), IC10.4 (V-); also elsewhere on the board
AOUTLN: R11.1; also elsewhere on the board
AOUTLN2: C39.2, IC7.3 (+IN_A), IC10.1 (OUT_A), R19.2, R30.2, TP22.1
AOUTLP: R17.1; also elsewhere on the board
AOUTLP2: C35.2, IC7.5 (+IN_B), IC10.7 (OUT_B), R13.2, R29.2, TP20.1
AOUTRN: R14.1; also elsewhere on the board
AOUTRN2: C41.2, IC8.5 (+IN_B), IC9.7 (OUT_B), R22.2, R24.2, TP23.1
AOUTRP: R20.1; also elsewhere on the board
AOUTRP2: C37.2, IC8.3 (+IN_A), IC9.1 (OUT_A), R16.2, R23.2, TP21.1
GND: C24.2, C27.2, C28.1, C29.1, C30.2, C31.2, C32.1, C33.1, C34.2, C36.2, C38.2, C40.2, C42.2, C43.1, C44.2, C45.1, C46.2, C47.1, C48.2, C49.1, C50.2, C51.1, C53.1, C55.1, C56.1, C57.1, IC4.21 (EP), IC7.9 (EP), IC8.9 (EP), IC9.3 (+IN_A), IC9.5 (+IN_B), IC9.9 (EP), IC10.3 (+IN_A), IC10.5 (+IN_B), IC10.9 (EP), J1.S, R6.1, R7.1, R25.1, R27.1, R34.1; also elsewhere on the board
HOL: IC4.2 (LOUT), R28.2, R32.1
HOR: IC4.19 (ROUT), R26.2, R31.2
LL: IC7.7 (OUT_B), R4.2, U5.P$1 (GND)
LR: IC8.1 (OUT_A), R10.2, U5.P$3 (TOP)
unnamed: C34.1, R11.2, R12.1, R13.1
unnamed: C36.1, R14.2, R15.1, R16.1
unnamed: C38.1, R17.2, R18.1, R19.1
unnamed: C40.1, R20.2, R21.1, R22.1
unnamed: IC4.4 (LIN+), R27.2, R29.1
unnamed: IC4.5 (LIN-), R28.1, R30.1
unnamed: IC4.17 (RIN+), R23.1, R25.2
unnamed: IC4.16 (RIN-), R24.1, R26.1
unnamed: J1.R, R31.1
unnamed: J1.T, R32.2
unnamed: R34.2, U5.P$2 (BTM)
OPA0: C37.1, IC9.2 (-IN_A), R15.2
OPA3: C41.1, IC9.6 (-IN_B), R21.2
OPA6: C35.1, IC10.6 (-IN_B), R12.2
OPA9: C39.1, IC10.2 (-IN_A), R18.2
OPA12: IC7.2 (-IN_A), R5.1, R6.2
OPA14: IC7.1 (OUT_A), R3.1, R5.2
OPA15: IC7.6 (-IN_B), R3.2, R4.1
OPA18: IC8.6 (-IN_B), R7.2, R8.1
OPA20: IC8.7 (OUT_B), R8.2, R9.1
OPA21: IC8.2 (-IN_A), R9.2, R10.1

Notes on the sheet:
Single Ended Conversion - Line Out
Headphone Amplifier
Power
MFB Filter
Lowpass Butterworth Second Order MFB Passband Freq (-3dB): 96 KHz Stopband Atten: -22.644dB Stopband Freq: 353 KHz Gain: 0dB
