yumenegi/object67/object67/object67.kicad_pcb

## KiCad design object67/object67.kicad_pcb (continued)

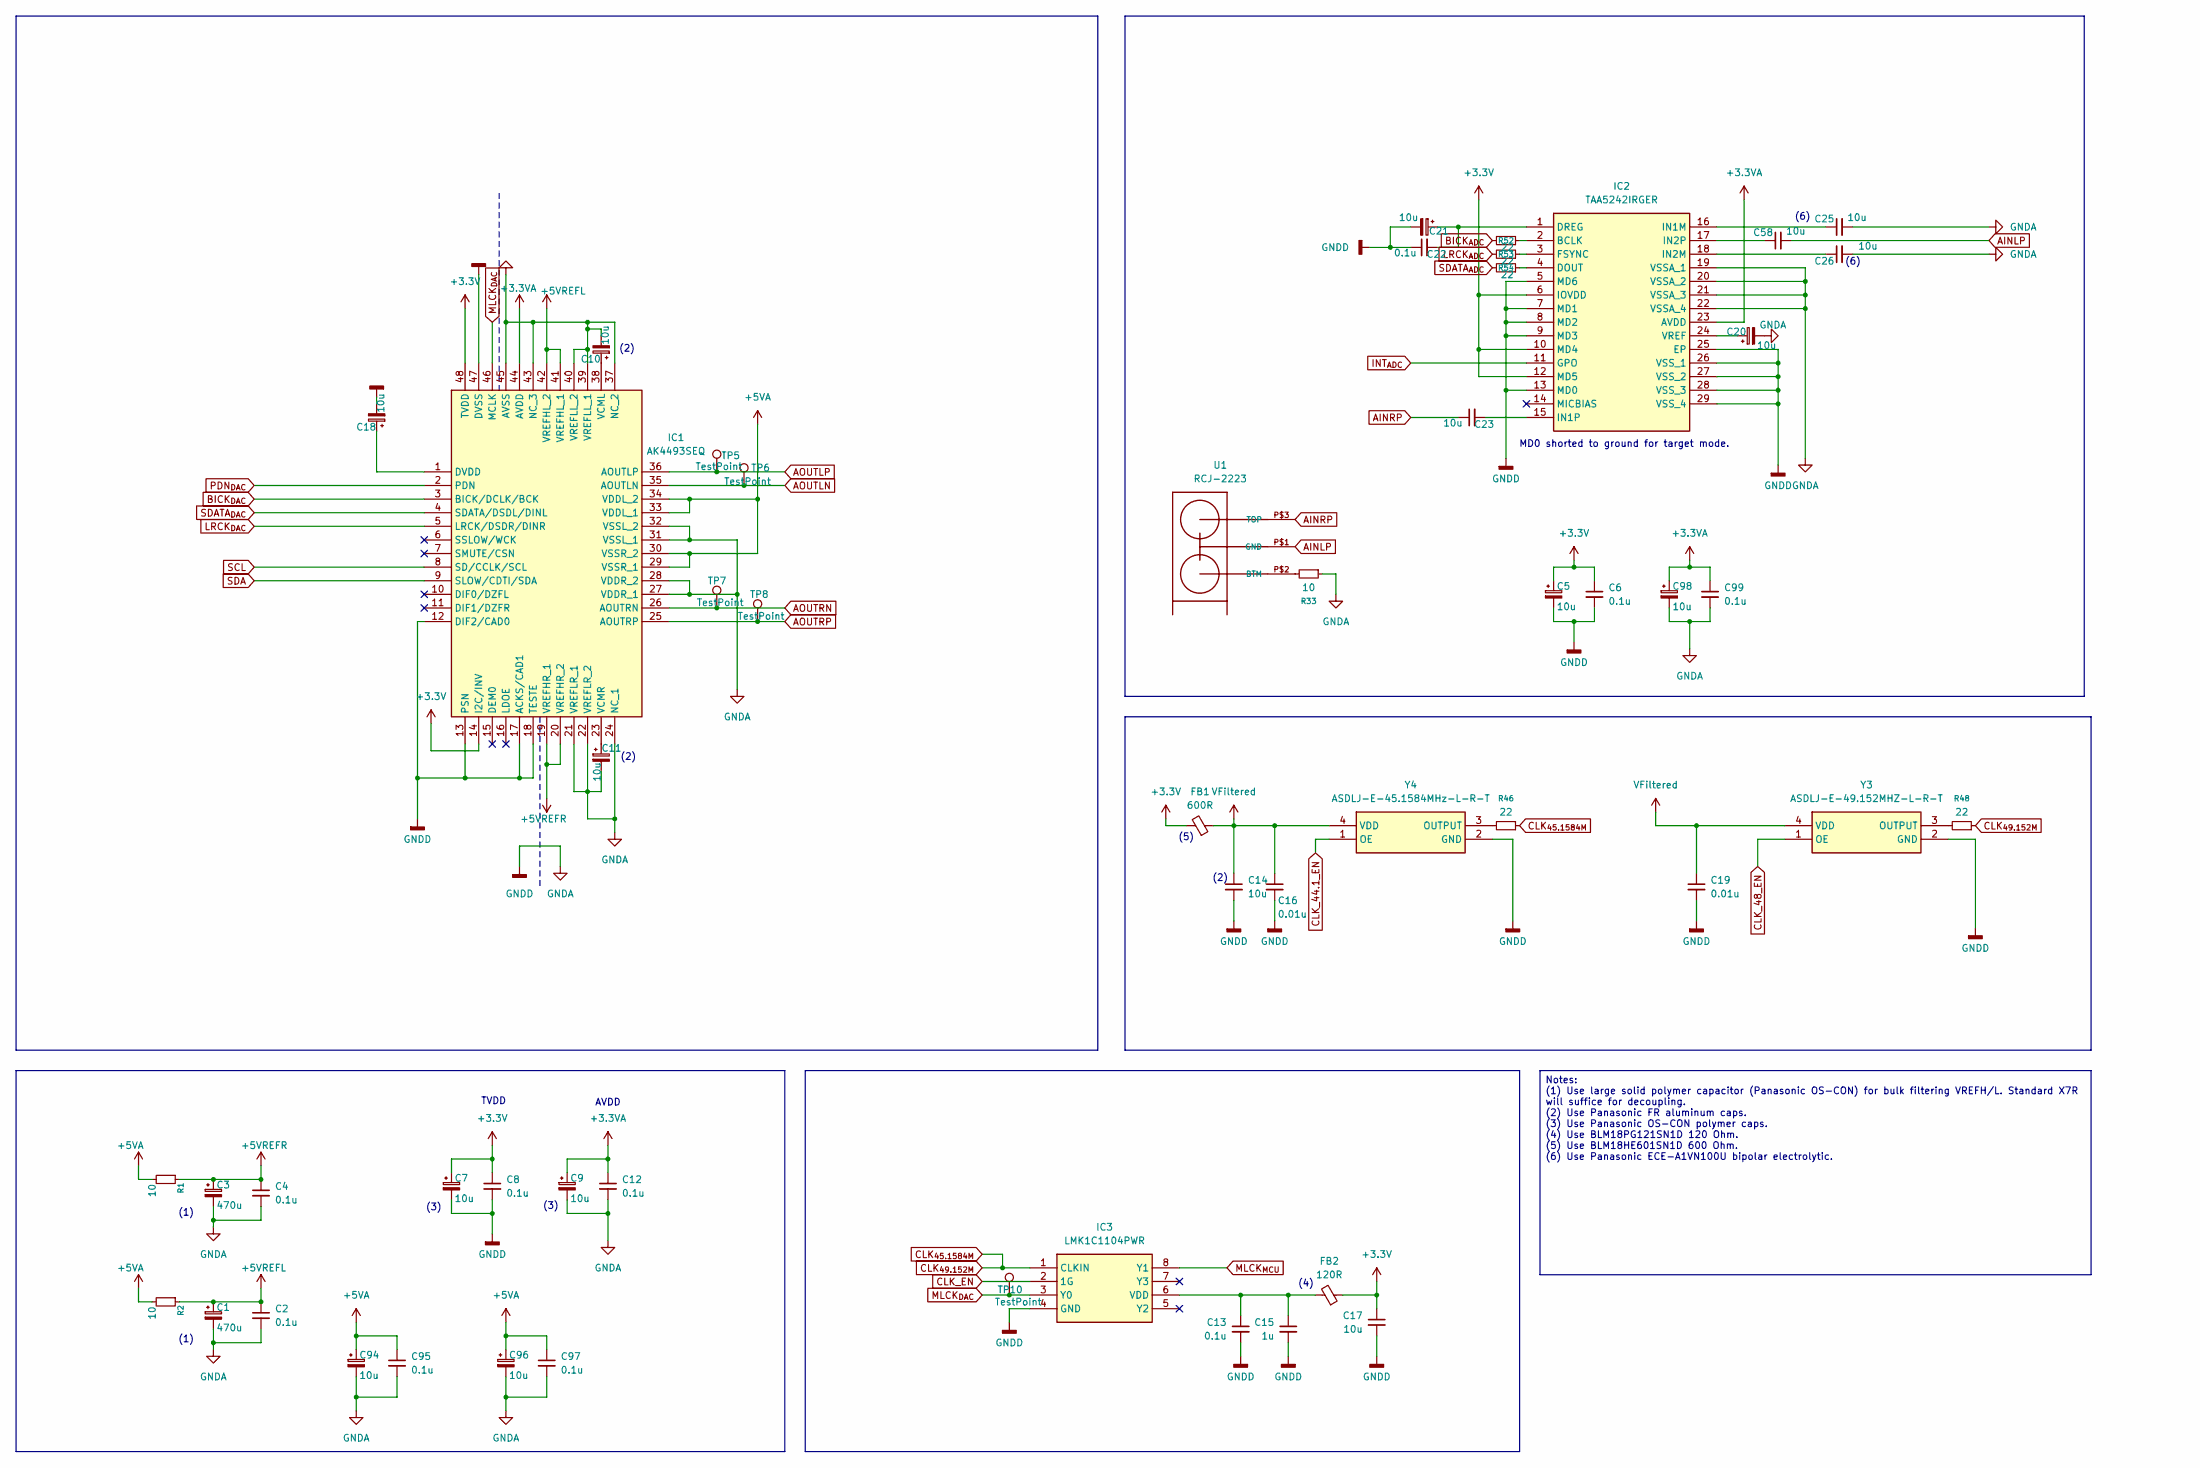
[picture p25: schematic audio.kicad_sch]

Parts:
C1, C3: 470u; CP_Radial_D8.0mm_P5.00mm
C2, C4, C6, C8, C12, C13, C95, C97, C99: 0.1u; C_0603_1608Metric
C5, C7, C9, C14, C18, C20, C21, C98: 10u; CP_Elec_4x5.3
C10, C11: 10u; CP_Radial_D5.0mm_P2.00mm
C15: 1u; C_1206_3216Metric
C16, C19: 0.01u; C_0402_1005Metric
C17, C23, C25, C26, C58: 10u; C_1206_3216Metric
C22: 0.1u; C_0402_1005Metric
C94, C96: 10u; CP_Elec_5x5.3
FB1: 600R; L_0603_1608Metric
FB2: 120R; L_0603_1608Metric
IC1: AK4493SEQ; LQFP-48_7x7mm_P0.5mm; Manufacturer_Part_Number AK4493SEQ; Mouser Part Number 412-AK4493SEQ
IC2: TAA5242IRGER; Manufacturer_Part_Number TAA5242IRGER
IC3: LMK1C1104PWR; TSSOP-8_4.4x3mm_P0.65mm; Manufacturer_Part_Number LMK1C1104PWR; Mouser Part Number 595-LMK1C1104PWR
R1, R2: 10; R_0402_1005Metric
R33: 10; R_1206_3216Metric
R46, R48, R52, R53, R54: 22; R_0402_1005Metric
TP5, TP6, TP7, TP8, TP10: TestPoint; TestPoint_Pad_D1.0mm
U1: RCJ-2223; DUALRCA
Y3: ASDLJ-E-49.152MHZ-L-R-T; ASDLJE49152MHZLRT; Manufacturer_Part_Number ASDLJ-E-49.152MHZ-L-R-T; Mouser Part Number 815-ASDLJE49152MHLRT
Y4: ASDLJ-E-45.1584MHz-L-R-T; ASDLJE451584MHzLRT; Manufacturer_Part_Number ASDLJ-E-45.1584MHz-L-R-T; Mouser Part Number 815-ASDLJE451584MLRT

Connections:
+3.3V: C5.1, C6.1, C7.1, C8.1, C17.1, FB1.2, FB2.1, IC1.14 (I2C/INV), IC1.48 (TVDD), IC2.6 (IOVDD), IC2.10 (MD4), IC2.12 (MD5); also elsewhere on the board
+3.3VA: C9.1, C12.1, C98.1, C99.1, IC1.44 (AVDD), IC2.23 (AVDD); also elsewhere on the board
+5VA: C94.1, C95.1, C96.1, C97.1, IC1.29 (VSSR_1), IC1.30 (VSSR_2), IC1.33 (VDDL_1), IC1.34 (VDDL_2), R1.2, R2.2; also elsewhere on the board
+5VREFL: C1.1, C2.1, IC1.41 (VREFHL_1), IC1.42 (VREFHL_2), R2.1
+5VREFR: C3.1, C4.1, IC1.19 (VREFHR_1), IC1.20 (VREFHR_2), R1.1
AINLP: C58.2, U1.P$1 (GND)
AINRP: C23.1, U1.P$3 (TOP)
AOUTLN: IC1.35 (AOUTLN), TP6.1; also elsewhere on the board
AOUTLP: IC1.36 (AOUTLP), TP5.1; also elsewhere on the board
AOUTRN: IC1.26 (AOUTRN), TP7.1; also elsewhere on the board
AOUTRP: IC1.25 (AOUTRP), TP8.1; also elsewhere on the board
BICK_{ADC}: R52.2; also elsewhere on the board
BICK_{DAC}: IC1.3 (BICK/DCLK/BCK); also elsewhere on the board
CLK_44.1_EN: Y4.1 (OE); also elsewhere on the board
CLK_48_EN: Y3.1 (OE); also elsewhere on the board
CLK_EN: IC3.2 (1G); also elsewhere on the board
CLK_{45.1584M}: IC3.1 (CLKIN), R46.1, R48.1
GND: C1.2, C2.2, C3.2, C4.2, C5.2, C6.2, C7.2, C8.2, C9.2, C10.2, C11.2, C12.2, C13.2, C14.2, C15.2, C16.2, C17.2, C18.2, C19.2, C20.2, C21.2, C22.1, C25.2, C26.2, C94.2, C95.2, C96.2, C97.2, C98.2, C99.2, IC1.12 (DIF2/CAD0), IC1.13 (PSN), IC1.17 (ACKS/CAD1), IC1.18 (TESTE), IC1.21 (VREFLR_1), IC1.22 (VREFLR_2), IC1.24 (NC_1), IC1.27 (VDDR_1), IC1.28 (VDDR_2), IC1.31 (VSSL_1), IC1.32 (VSSL_2), IC1.37 (NC_2), IC1.39 (VREFLL_1), IC1.40 (VREFLL_2), IC1.43 (NC_3), IC1.45 (AVSS), IC1.47 (DVSS), IC2.5 (MD6), IC2.7 (MD1), IC2.8 (MD2), IC2.9 (MD3), IC2.13 (MD0), IC2.19 (VSSA_1), IC2.20 (VSSA_2), IC2.21 (VSSA_3), IC2.22 (VSSA_4), IC2.25 (EP), IC2.26 (VSS_1), IC2.27 (VSS_2), IC2.28 (VSS_3), IC2.29 (VSS_4), IC3.4 (GND), R33.1, Y3.2 (GND), Y4.2 (GND); also elsewhere on the board
INT_{ADC}: IC2.11 (GPO); also elsewhere on the board
LRCK_{ADC}: R53.2; also elsewhere on the board
LRCK_{DAC}: IC1.5 (LRCK/DSDR/DINR); also elsewhere on the board
MLCK_{DAC}: IC1.46 (MCLK), IC3.3 (Y0), TP10.1
MLCK_{MCU}: IC3.8 (Y1); also elsewhere on the board
unnamed: C18.1, IC1.1 (DVDD)
unnamed: C10.1, IC1.38 (VCML)
unnamed: C11.1, IC1.23 (VCMR)
unnamed: IC2.2 (BCLK), R52.1
unnamed: IC2.4 (DOUT), R54.1
unnamed: C21.1, C22.2, IC2.1 (DREG)
unnamed: IC2.3 (FSYNC), R53.1
unnamed: C25.1, IC2.16 (IN1M)
unnamed: C23.2, IC2.15 (IN1P)
unnamed: C26.1, IC2.18 (IN2M)
unnamed: C58.1, IC2.17 (IN2P)
unnamed: C20.1, IC2.24 (VREF)
unnamed: C13.1, C15.1, FB2.2, IC3.6 (VDD)
unnamed: R33.2, U1.P$2 (BTM)
unnamed: R48.2, Y3.3 (OUTPUT)
unnamed: R46.2, Y4.3 (OUTPUT)
PDN_{DAC}: IC1.2 (PDN); also elsewhere on the board
SCL: IC1.8 (SD/CCLK/SCL); also elsewhere on the board
SDA: IC1.9 (SLOW/CDTI/SDA); also elsewhere on the board
SDATA_{ADC}: R54.2; also elsewhere on the board
SDATA_{DAC}: IC1.4 (SDATA/DSDL/DINL); also elsewhere on the board
VFiltered: C14.1, C16.1, C19.1, FB1.1, Y3.4 (VDD), Y4.4 (VDD)

Notes on the sheet:
(2)
(3)
(1)
MD0 shorted to ground for target mode.
(6)
TVDD
(4)
AVDD
(5)
Notes: (1) Use large solid polymer capacitor (Panasonic OS-CON) for bulk filtering VREFH/L. Standard X7R will suffice for decoupling. (2) Use Panasonic FR aluminum caps. (3) Use Panasonic OS-CON polymer caps. (4) Use BLM18PG121SN1D 120 Ohm. (5) Use BLM18HE601SN1D 600 Ohm. (6) Use Panasonic ECE-A1VN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

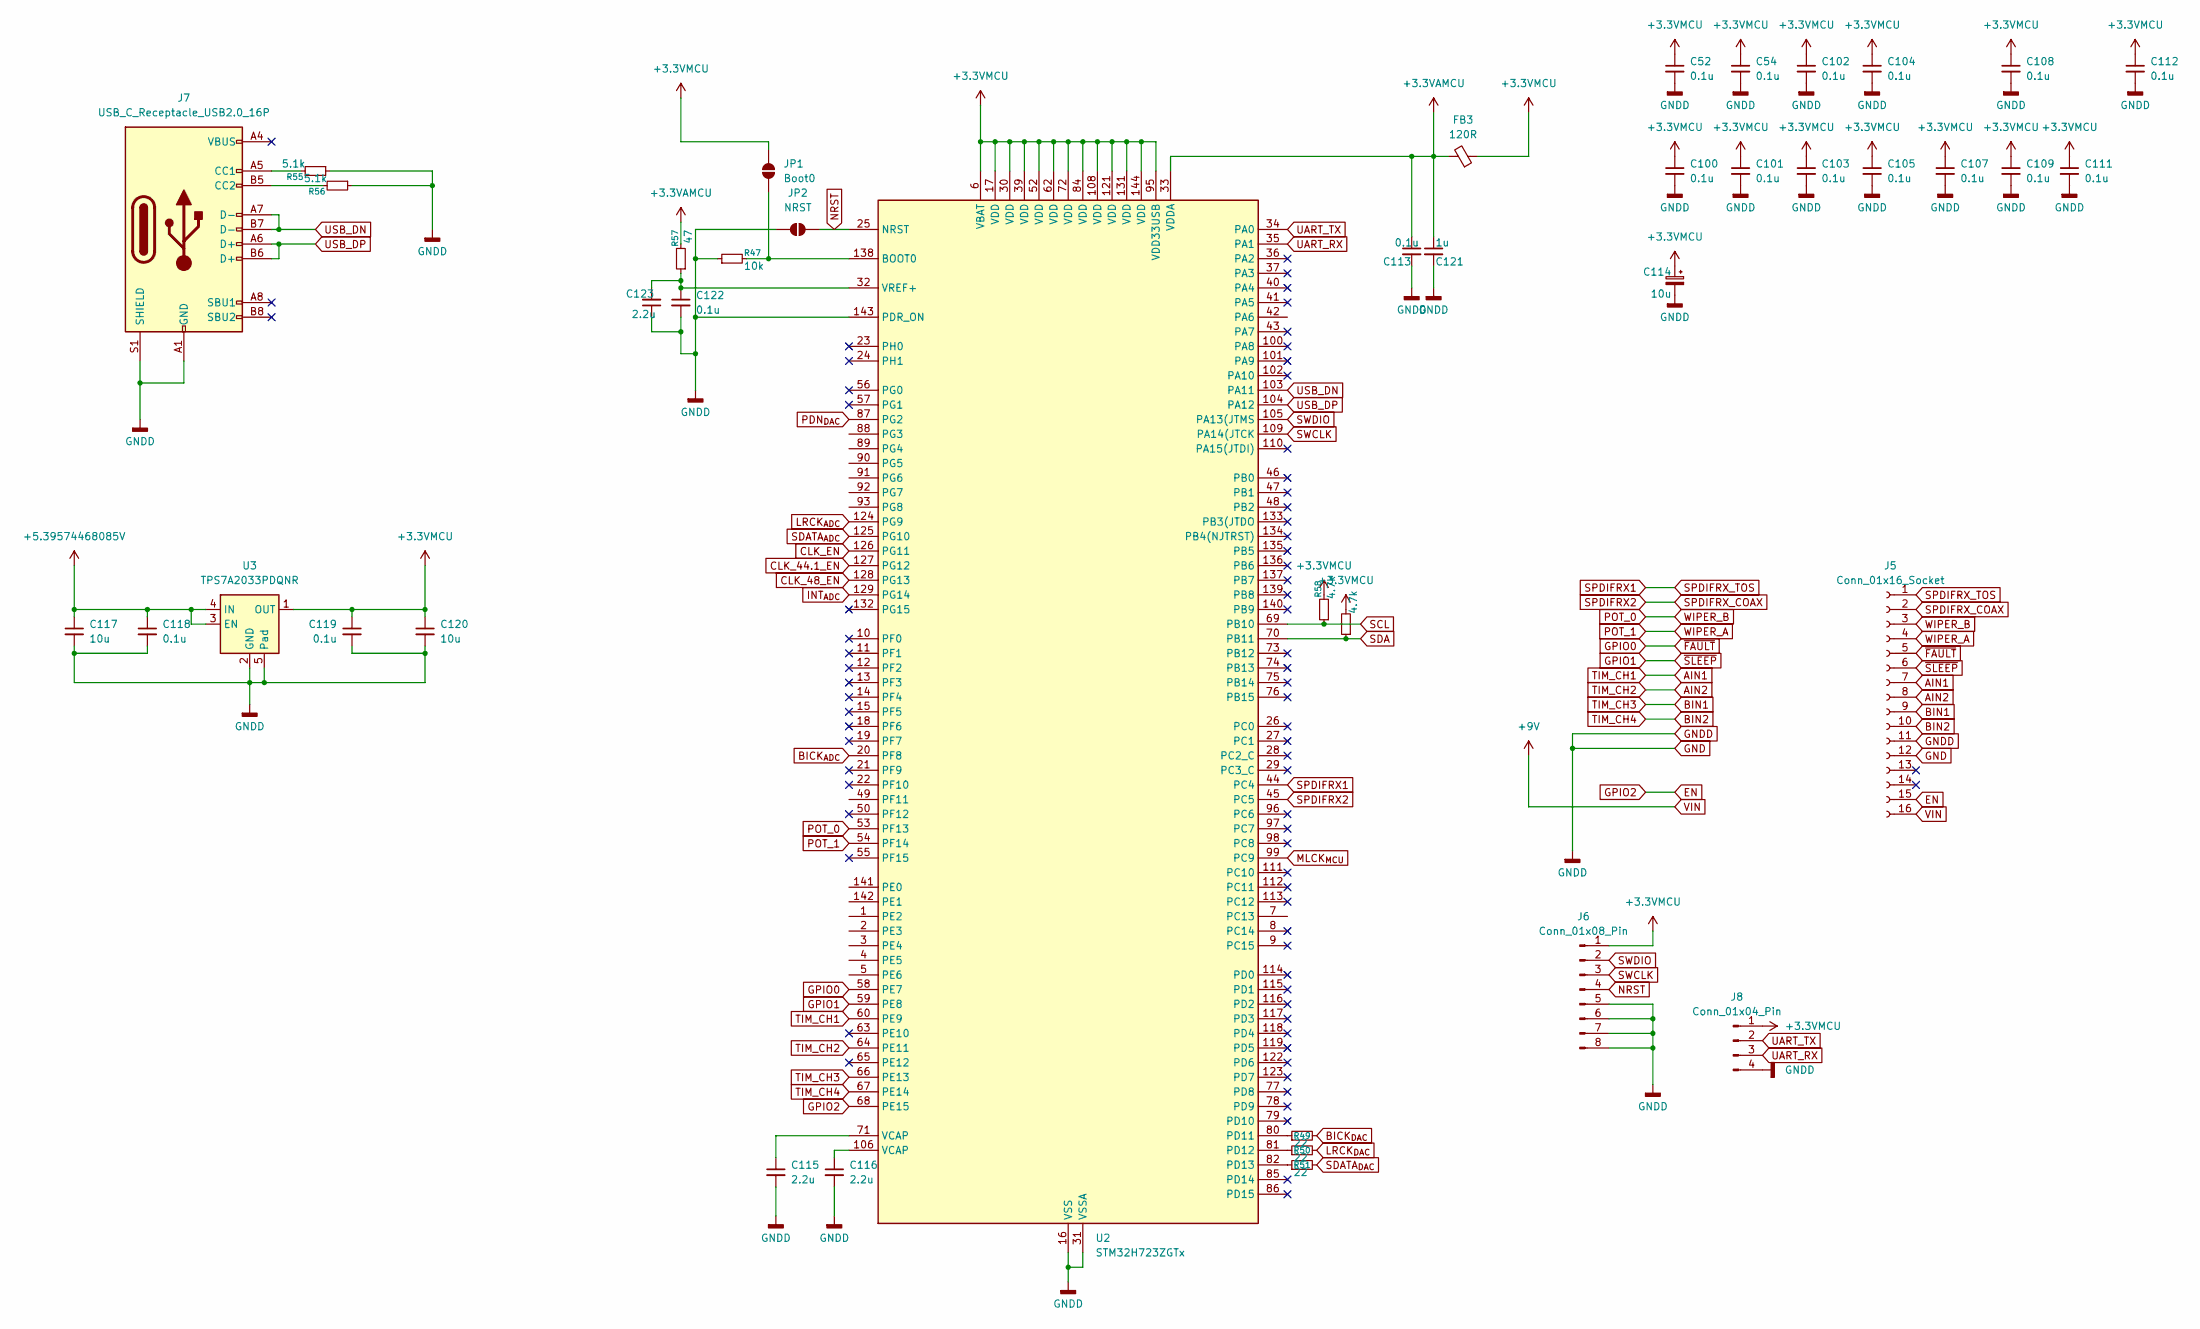
[picture p26: schematic mcu.kicad_sch]

Parts:
C52, C54, C100, C101, C102, C103, C104, C105, C107, C108, C109, C111, C112, C113, C122: 0.1u; C_0402_1005Metric
C114: 10u; CP_Elec_4x5.3
C115, C116, C123: 2.2u; C_0603_1608Metric
C117, C120: 10u; C_0603_1608Metric
C118, C119: 0.1u; C_0603_1608Metric
C121: 1u; C_1206_3216Metric
FB3: 120R; L_0603_1608Metric
J5: Conn_01x16_Socket; JST_PH_S16B-PH-K_1x16_P2.00mm_Horizontal
J6: Conn_01x08_Pin; PinHeader_1x08_P2.54mm_Vertical
J7: USB_C_Receptacle_USB2.0_16P; USB_C_Receptacle_GCT_USB4085
J8: Conn_01x04_Pin; PinHeader_1x04_P2.54mm_Vertical
JP1: Boot0; SolderJumper-2_P1.3mm_Open_RoundedPad1.0x1.5mm
JP2: NRST; SolderJumper-2_P1.3mm_Open_RoundedPad1.0x1.5mm
R47: 10k; R_0603_1608Metric
R49, R50, R51: 22; R_0402_1005Metric
R55, R56: 5.1k; R_0603_1608Metric
R57: 47; R_0603_1608Metric
R58, R59: 4.7k; R_0603_1608Metric
U2: STM32H723ZGTx; LQFP-144_20x20mm_P0.5mm
U3: TPS7A2033PDQNR; Texas_X2SON-4_1x1mm_P0.65mm

Connections:
+3.3VAMCU: C113.1, C121.1, FB3.2, R57.2, U2.33 (VDDA)
+3.3VMCU: C52.1, C54.1, C100.1, C101.1, C102.1, C103.1, C104.1, C105.1, C107.1, C108.1, C109.1, C111.1, C112.1, C114.1, C119.1, C120.1, FB3.1, J6.1, J8.1, JP1.2 (B), R58.2, R59.2, U2.6 (VBAT), U2.17 (VDD), U2.30 (VDD), U2.39 (VDD), U2.52 (VDD), U2.62 (VDD), U2.72 (VDD), U2.84 (VDD), U2.95 (VDD33USB), U2.108 (VDD), U2.121 (VDD), U2.131 (VDD), U2.144 (VDD), U3.1 (OUT); also elsewhere on the board
+5.39574468085V: C117.1, C118.1, U3.3 (EN), U3.4 (IN); also elsewhere on the board
AIN1: J5.7, U2.60 (PE9)
AIN2: J5.8, U2.64 (PE11)
BICK_{ADC}: U2.20 (PF8); also elsewhere on the board
BICK_{DAC}: R49.2; also elsewhere on the board
BIN1: J5.9, U2.66 (PE13)
BIN2: J5.10, U2.67 (PE14)
CLK_44.1_EN: U2.127 (PG12); also elsewhere on the board
CLK_48_EN: U2.128 (PG13); also elsewhere on the board
CLK_EN: U2.126 (PG11); also elsewhere on the board
EN: J5.15, U2.68 (PE15)
GND: C52.2, C54.2, C100.2, C101.2, C102.2, C103.2, C104.2, C105.2, C107.2, C108.2, C109.2, C111.2, C112.2, C113.2, C114.2, C115.2, C116.2, C117.2, C118.2, C119.2, C120.2, C121.2, C122.2, C123.1, J5.11, J5.12, J6.5, J6.6, J6.7, J6.8, J7.A1 (GND), J7.A12 (GND), J7.B1 (GND), J7.B12 (GND), J7.S1 (SHIELD), J8.4, JP2.1 (A), R47.1, R55.1, R56.1, U2.16 (VSS), U2.31 (VSSA), U2.38 (VSS), U2.51 (VSS), U2.61 (VSS), U2.83 (VSS), U2.94 (VSS), U2.107 (VSS), U2.120 (VSS), U2.130 (VSS), U2.143 (PDR_ON), U3.2 (GND), U3.5 (Pad); also elsewhere on the board
GPIO0: J5.5, U2.58 (PE7)
GPIO1: J5.6, U2.59 (PE8)
INT_{ADC}: U2.129 (PG14); also elsewhere on the board
LRCK_{ADC}: U2.124 (PG9); also elsewhere on the board
LRCK_{DAC}: R50.2; also elsewhere on the board
MLCK_{MCU}: U2.99 (PC9); also elsewhere on the board
NRST: J6.4, JP2.2 (B), U2.25 (NRST)
unnamed: C115.1, U2.71 (VCAP)
unnamed: C116.1, U2.106 (VCAP)
unnamed: J7.A5 (CC1), R55.2
unnamed: J7.B5 (CC2), R56.2
unnamed: JP1.1 (A), R47.2, U2.138 (BOOT0)
unnamed: R49.1, U2.80 (PD11)
unnamed: R50.1, U2.81 (PD12)
unnamed: R51.1, U2.82 (PD13)
unnamed: C122.1, C123.2, R57.1, U2.32 (VREF+)
PDN_{DAC}: U2.87 (PG2); also elsewhere on the board
POT_0: J5.3, U2.53 (PF13)
POT_1: J5.4, U2.54 (PF14)
SCL: R58.1, U2.69 (PB10); also elsewhere on the board
SDA: R59.1, U2.70 (PB11); also elsewhere on the board
SDATA_{ADC}: U2.125 (PG10); also elsewhere on the board
SDATA_{DAC}: R51.2; also elsewhere on the board
SPDIFRX1: J5.1, U2.44 (PC4)
SPDIFRX2: J5.2, U2.45 (PC5)
SWCLK: J6.3, U2.109 (PA14(JTCK)
SWDIO: J6.2, U2.105 (PA13(JTMS)
UART_RX: J8.3, U2.35 (PA1)
UART_TX: J8.2, U2.34 (PA0)
USB_DN: J7.A7 (D-), J7.B7 (D-), U2.103 (PA11)
USB_DP: J7.A6 (D+), J7.B6 (D+), U2.104 (PA12)
VIN: J5.16; also elsewhere on the board

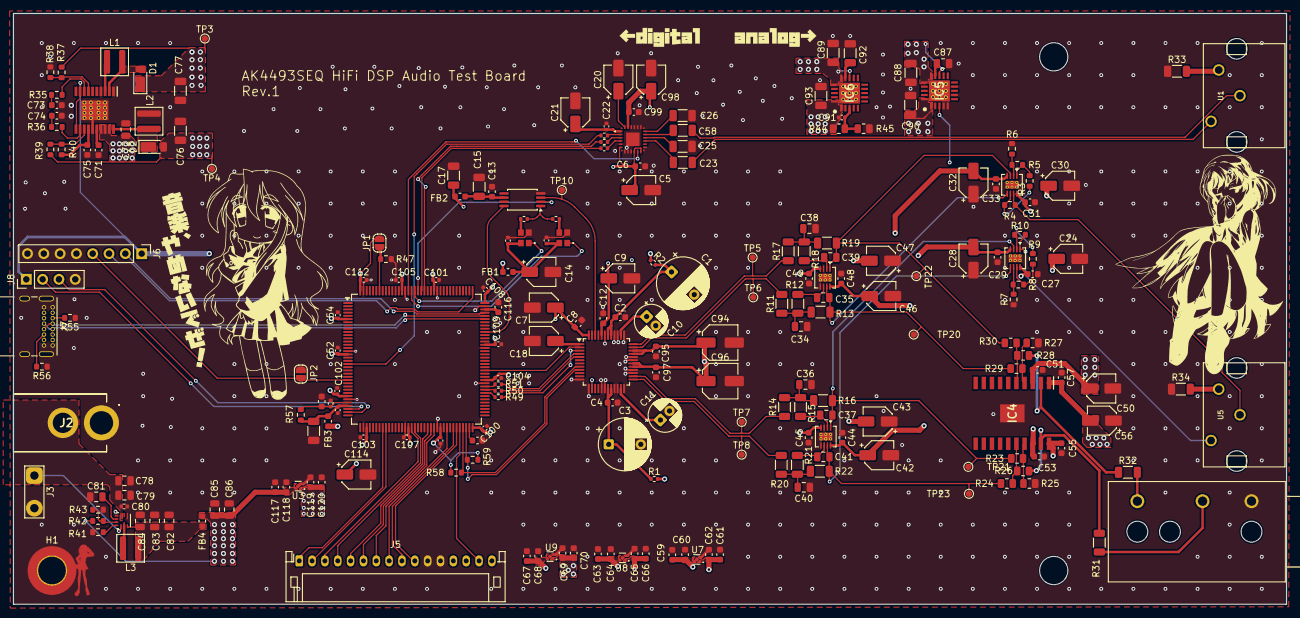
[picture p27: board object67.kicad_pcb from above]

Board: 4 copper layers, 198.2 x 92.0 mm, 231 parts (0 on the bottom side), 128 nets.
