yumenegi/object67/application/object67/Core/Src/main.c

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
/* Includes ------------------------------------------------------------------*/
#include "main.h"
#include "adc.h"
#include "i2c.h"
#include "sai.h"
#include "spdifrx.h"
#include "tim.h"
#include "usart.h"
#include "usb_device.h"
#include "gpio.h"


void SystemClock_Config(void);
static void MPU_Config(void);
/**
  * @brief  The application entry point.
  * @retval int
  */
int main(void)
{

  /* MPU Configuration--------------------------------------------------------*/
  MPU_Config();

  /* MCU Configuration--------------------------------------------------------*/

  /* Reset of all peripherals, Initializes the Flash interface and the Systick. */
  HAL_Init();

  /* Configure the system clock */
  SystemClock_Config();

  /* Initialize all configured peripherals */
  MX_GPIO_Init();
  MX_SPDIFRX1_Init();
  MX_USB_DEVICE_Init();
  MX_ADC1_Init();
  MX_I2C1_Init();
  MX_SAI1_Init();
  MX_TIM1_Init();
  MX_UART4_Init();
  /* USER CODE BEGIN 2 */
  uint8_t init[] = {0x1B, 0x40};
  HAL_StatusTypeDef err = HAL_UART_Transmit(&huart4, init, 2, 0xFFFF);

  HAL_Delay(3);

  uint8_t bright[] = {0x1F, 0x58, 8};
  err = HAL_UART_Transmit(&huart4, bright, 3, 0xFFFF);

  HAL_Delay(3);

  uint8_t screensaver[] = {0x1F, 0x28, 0x61, 0x40, 1};
  err = HAL_UART_Transmit(&huart4, screensaver, 8, 0xFFFF);

  HAL_Delay(3);

  uint8_t test[] = "hello gamers.";
//  uint8_t test[] = "Hi Nikita!!!!";
  err = HAL_UART_Transmit(&huart4, test, 13, 0xFFFF);

  HAL_Delay(3);

  uint8_t blink[] = {0x1F, 0x28, 0x61, 0x11, 1, 50, 50, 5};
  err = HAL_UART_Transmit(&huart4, blink, 8, 0xFFFF);

  /* USER CODE END 2 */

  /* Infinite loop */
  /* USER CODE BEGIN WHILE */
  while (1)
  {
    /* USER CODE END WHILE */

    /* USER CODE BEGIN 3 */
	  HAL_Delay(1000);
	  HAL_GPIO_TogglePin(GPIOB, GPIO_PIN_5);
	  HAL_GPIO_TogglePin(GPIOB, GPIO_PIN_14);

  }
  /* USER CODE END 3 */
}

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
 /* MPU Configuration */

void MPU_Config(void)
{
  MPU_Region_InitTypeDef MPU_InitStruct = {0};

  /* Disables the MPU */
  HAL_MPU_Disable();

  /** Initializes and configures the Region and the memory to be protected
  */
  MPU_InitStruct.Enable = MPU_REGION_ENABLE;
  MPU_InitStruct.Number = MPU_REGION_NUMBER0;
  MPU_InitStruct.BaseAddress = 0x0;
  MPU_InitStruct.Size = MPU_REGION_SIZE_4GB;
  MPU_InitStruct.SubRegionDisable = 0x87;
  MPU_InitStruct.TypeExtField = MPU_TEX_LEVEL0;
  MPU_InitStruct.AccessPermission = MPU_REGION_NO_ACCESS;
  MPU_InitStruct.DisableExec = MPU_INSTRUCTION_ACCESS_DISABLE;
  MPU_InitStruct.IsShareable = MPU_ACCESS_SHAREABLE;
  MPU_InitStruct.IsCacheable = MPU_ACCESS_NOT_CACHEABLE;
  MPU_InitStruct.IsBufferable = MPU_ACCESS_NOT_BUFFERABLE;

  HAL_MPU_ConfigRegion(&MPU_InitStruct);
  /* Enables the MPU */
  HAL_MPU_Enable(MPU_PRIVILEGED_DEFAULT);

}

/**
  * @brief  This function is executed in case of error occurrence.
  * @retval None
  */
void Error_Handler(void)
{
  /* USER CODE BEGIN Error_Handler_Debug */
  /* User can add his own implementation to report the HAL error return state */
  __disable_irq();
  while (1)
  {
  }
  /* USER CODE END Error_Handler_Debug */
}
#ifdef USE_FULL_ASSERT
/**
  * @brief  Reports the name of the source file and the source line number
  *         where the assert_param error has occurred.
  * @param  file: pointer to the source file name
  * @param  line: assert_param error line source number
  * @retval None
  */
void assert_failed(uint8_t *file, uint32_t line)
{
  /* USER CODE BEGIN 6 */
  /* User can add his own implementation to report the file name and line number,
     ex: printf("Wrong parameters value: file %s on line %d\r\n", file, line) */
  /* USER CODE END 6 */
}
#endif /* USE_FULL_ASSERT */
