yumenegi/object67/application/object67/object67.ioc

Mcu.UserName=STM32H723ZGTx
PA0.Signal=UART4_TX
PA1.Signal=UART4_RX
PA11.Signal=USB_OTG_HS_DM
PA12.Signal=USB_OTG_HS_DP
PA13(JTMS/SWDIO).Signal=DEBUG_JTMS-SWDIO
PA14(JTCK/SWCLK).Signal=DEBUG_JTCK-SWCLK
PA6.Signal=ADCx_INP3
PB14.Signal=GPIO_Output
PB5.Signal=GPIO_Output
PB6.Signal=I2C1_SCL
PB7.Signal=I2C1_SDA
PC9.Signal=I2S_CKIN
PD10.Signal=GPIO_Output
PD11.Signal=GPIO_Output
PD12.Signal=GPXTI12
PD15.Signal=GPIO_Output
PD7.Signal=SPDIFRX1_IN0
PD8.Signal=SPDIFRX1_IN1
PE11.Signal=S_TIM1_CH2
PE13.Signal=S_TIM1_CH3
PE14.Signal=S_TIM1_CH4
PE3.Signal=SAI1_SD_B
PE4.Signal=SAI1_FS_A
PE5.Signal=SAI1_SCK_A
PE6.Signal=SAI1_SD_A
PE9.Signal=S_TIM1_CH1
PF11.Signal=ADC1_INP2
PF8.Signal=SAI1_SCK_B
PF9.Signal=SAI1_FS_B
PG2.Signal=GPIO_Output
PG3.Signal=GPIO_Output
PG4.Signal=GPIO_Output
PG5.Signal=GPIO_Output
PG6.Signal=GPIO_Output
PG7.Signal=GPIO_Output
PG8.Signal=GPIO_Output
