yumenegi/object67/(commit log)

2026-02-06 Added datasheets and kicad project
    [object67.kicad_pcb, object67.kicad_sch]
2026-02-10 Added motor_board KiCad Project
    [motor_board.kicad_pcb, motor_board.kicad_sch]
2026-02-11 Added TODO for motor_board
    [motor_board.kicad_sch]
2026-02-11 Created subpages
    [motor.kicad_sch, object67.kicad_sch, xsp_main.kicad_sch]
2026-02-12 Finished schematic for DAC
    [AK4493SEQ.SchLib, AK4493SEQ.stp, AK5572EN.SchLib, AK5572EN.stp, EDI2CAP.CFG, LMK1C1104DQFR.SchLib, LMK1C1104DQFR.stp, LMK1C1104PWR.SchLib]
2026-02-16 Finished motor_board & added SPDIF
    [EDI2CAP.CFG, TORX1950A_F_.stp, chips.prt, motor_board.kicad_sch, motor_driver.kicad_sch, spdif.kicad_sch, torx1950af.psm]
2026-02-23 Began motor board layour
    [motor_board.kicad_pcb, motor_board.kicad_sch, motor_driver.kicad_sch, spdif.kicad_sch]
2026-02-24 Finished motor board PCB
    [motor_board.kicad_pcb, motor_board.kicad_sch, motor_driver.kicad_sch]
2026-02-24 Analog frontend
    [EDI2CAP.CFG, RCJ-2223.step, SOIC127P1040X275-21N.PcbLib, TPA6120A2DWPR.SchLib, TPA6120A2DWPR.stp, audio.kicad_sch, chips.prt, frontend.kicad_sch]
2026-02-24 Front end complete
    [frontend.kicad_sch]
2026-02-24 KiCad crashed
    [frontend.kicad_sch]
2026-02-24 KiCad crashed x2
    [audio.kicad_sch, frontend.kicad_sch, xsp_main.kicad_sch]
2026-02-24 Update feedback resistor value
    [frontend.kicad_sch]
2026-02-24 Switching power supply
    [frontend.kicad_sch, xsp_main.kicad_sch]
2026-03-03 そうじしました
2026-03-07 Add LDO
    [216700-0249.SchLib, 216700-0249.stp, 2167000249.PcbLib, 2167000249.psm, 505270-2412.SchLib, 505270-2412.stp, 5052702412.PcbLib, 5052702412.psm]
2026-03-07 Updated models
    [ASDLJ-E-45.1584MHz-L-R-T.SchLib, ASDLJ-E-45.1584MHz-L-R-T.stp, ASDLJ-E-49.152MHZ-L-R-T.SchLib, ASDLJ-E-49.152MHZ-L-R-T.stp, ASDLJE451584MHzLRT.PcbLib, ASDLJE49152MHZLRT.PcbLib, EDI2CAP.CFG, asdlje451584mhzlrt.psm]
2026-03-07 Finished layout
    [audio.kicad_sch, frontend.kicad_sch, xsp_main.kicad_sch]
2026-03-09 Start layout
    [audio.kicad_sch, frontend.kicad_sch, object67.kicad_pcb, xsp_main.kicad_sch]
2026-03-09 Updated pcb
    [DQN0004A.stp, RPU0010A.stp, audio.kicad_sch, object67.kicad_pcb, xsp_main.kicad_sch]
2026-03-09 More layouts
    [audio.kicad_sch, object67.kicad_pcb]
2026-03-09 Layout for ADP5070
    [ADP5070AREZ.SchLib, ADP5070AREZ.stp, EDI2CAP.CFG, SOP65P640X120-21N.PcbLib, chips.prt, object67.kicad_pcb, sop65p640x120-21n.psm, xsp_main.kicad_sch]
2026-03-09 Finished layout for ADC DAC, starting filter
    [audio.kicad_sch, frontend.kicad_sch, object67.kicad_pcb, xsp_main.kicad_sch]
2026-03-10 Finished layout, start MCU
    [audio.kicad_sch, frontend.kicad_sch, mcu.kicad_sch, object67.kicad_pcb, xsp_main.kicad_sch]
2026-03-12 Test via stitching
    [object67.kicad_pcb]
2026-03-22 Modified motor_board; larger DC/DC inductor
    [motor_board.kicad_pcb, motor_board.kicad_sch, motor_driver.kicad_sch, spdif.kicad_sch]
