yumenegi/object67/(notices)

Notices in the files:
application/object67/Core/Src/tim.c:
Copyright (c) 2026 STMicroelectronics.
All rights reserved.
This software is licensed under terms that can be found in the LICENSE file
